Logicenios/C5VRX/docs/diagnostic-led-firmware.md

# Diagnostic LED Firmware & Empirical CVBS Raster Analysis

This document records the architecture, physical signaling protocol, empirical discoveries, and mathematical proof established by the **diagnostic information-gathering firmware** (CONFIG_C5VRX2_ISSUE11_CAPTURE) developed for Issue #11 on the Seeed Studio XIAO ESP32-C5 receiver.

---

## 1. Context & Purpose

Issue #11 investigated persistent image distortions observed on analog monitors during 5.8 GHz live video reception:
- Jagged diagonal edges along high-contrast vertical boundaries.
- Transparent repeating horizontal layers shifting in a repeating pattern (sawtooth/wedge shape).
- Repeating Red -> Green -> Blue chromatic bands across successive lines.

To conclusively resolve whether these artifacts originated in the analog domain (cable reflections, resistor DAC non-linearities, missing low-pass reconstruction) or digitally inside the ESP32-C5 (BitScrambler execution, demodulator algorithms, discrete raster quantization), a dedicated diagnostic capture firmware was engineered.

---

## 2. Diagnostic LED Signaling Protocol

The diagnostic firmware uses the onboard user LED (XIAO_USER_LED on GPIO_NUM_27, active-low) as a visible, hardware-timed state indicator. Because high-speed RF DMA and BitScrambler operations take exclusive bus ownership, visual LED feedback allows the operator to synchronize capture actions without host UART latency or serial jitter:

`
Boot / Wi-Fi Init
      |
      v
[ 3-Second Countdown ]  ---> 3 slow blinks (200 ms ON / 800 ms OFF)
      |                      Notifies user: capture is imminent, activate VTX
      v
[ Realtime Capture   ]  ---> Solid LED ON (active-low 0)
      |                      Simultaneous 40 MS/s RF Q4/I4 + 20 MS/s DAC capture
      v
[ Flash Write & Done ]  ---> 10 rapid strobe pulses (50 ms ON / 50 ms OFF)
      |                      Signals: capture stored in flash; safe to power off VTX
      v
[ Infinite CPU Halt  ]  ---> LED OFF; vTaskDelay(portMAX_DELAY)
                             Awaits host USB extraction (tools/read_diagcap.py)
`

### Hardware Capture Mechanics
1. **RF Input:** Acquires 32,768 bytes of continuous 40 MS/s raw Q4/I4 baseband from MODEM_DIAG on Wi-Fi channel 173 (5865 MHz, Band A1).
2. **BitScrambler Execution:** Streams the acquired RF buffer through the production BitScrambler program at 20 MS/s to drive DAC GPIOs (23, 24, 11, 12, 8, 9).
3. **GPIO Loopback Capture:** Synchronously captures 12,000 samples (600 us, 9 full video lines) directly from the DAC pins into SRAM via PARLIO RX.
4. **Flash Persistence:** Commits RF bytes, DAC samples, and a 64-byte diagnostic metadata record to the dedicated SPI flash diagcap partition.

---

## 3. Empirical Discoveries from the Diagnostic Dumps

Evaluating the hardware dump with Python analysis tooling (	ools/analyze_issue11_output.py) provided definitive proof:

### A. BitScrambler Hardware Execution is 100% Exact
- Comparing 12,000 captured physical DAC samples against the bit-exact software simulation:
  - Startup flush (samples 0-686): 337 differences during pipeline filling and phase-history zeroing.
  - Steady-state (samples 687-12,000): **0 mismatches out of 11,314 samples (100.00% exact match)**.
- **Verdict:** The ESP32-C5 BitScrambler peripheral executes instructions and LUT lookups without register corruption, bit slippage, or timing errors.

### B. Demodulator Core Comparison: Trajectory vs Phase 5
Comparing line synchronization stability across demodulation architectures:

| Demodulator Architecture | Measured Line Duration Range | Line Sample Count (at 20 MS/s) | Sync Jitter (RMS) | Visual Edge Stability |
|:---|:---:|:---:|:---:|:---|
| **Ideal Floating-Point FM** | 63.50 - 63.60 us | 1270 - 1272 samples | ~4.8 ns | Rock solid |
| **Phase 5 Polar Demodulator** | 63.45 - 63.65 us | 1269 - 1273 samples | ~9.7 ns | Clean, minimal drift |
| **PR #10 / PR #16 Trajectory** | **62.45 - 64.45 us** | **1249 - 1289 samples** | **> 112 ns** | Severe tearing, layer jumps |

- **Verdict:** The Trajectory LUT inherently introduced phase-tracking slips under noisy FM conditions, jumping tens of samples per line. Phase 5 polar demodulation keeps line lengths rock-solid at nominal NTSC. Phase 5 is locked in as the production baseline.

---

## 4. Mathematical Root Cause of the 9-Line Sawtooth & Color Layers

The diagnostic firmware captures revealed that even with a near-ideal demodulator, residual jagged edges exhibited a strict periodic pattern: the horizontal edge would drift incrementally to the right over successive lines, forming a diagonal slope/wedge, and then snap back.

### The 9-Line Raster Sawtooth Beat
Standard NTSC timing dictates:
H_{line} = 1001 / 15750000 s \approx 63.555556 us

At a 20 MS/s DAC clock rate ( = 50 ns$):
N_{samples} = 63.555556 us \times 20 MHz = 1271.11111... = 1271 + 1/9 samples/line

Because the line period is not an integer number of discrete 20 MHz clock cycles, every horizontal line starts /9 sample = 50/9 ns \approx 5.555 ns$ later relative to the discrete DAC sampling grid:

| Line Number | Fractional Grid Phase | Continuous Time Drift | Discrete 20 MS/s DAC Quantized Step |
|:---:|:---:|:---:|:---:|
| Line 1 | 0/9 | +0.00 ns | 0 samples (baseline) |
| Line 2 | 1/9 | +5.56 ns | 0 samples |
| Line 3 | 2/9 | +11.11 ns | 0 samples |
| Line 4 | 3/9 | +16.67 ns | 0 samples |
| Line 5 | 4/9 | +22.22 ns | 0 samples |
| Line 6 | 5/9 | +27.78 ns | +1 sample transition threshold |
| Line 7 | 6/9 | +33.33 ns | +1 sample |
| Line 8 | 7/9 | +38.89 ns | +1 sample |
| Line 9 | 8/9 | +44.44 ns | +1 sample |
| Line 10 | 9/9 = 1 | +50.00 ns | **+1 full sample slip & reset** |

Across 9 lines, the horizontal threshold crossing shifts by up to 50 ns (1 full pixel). On an analog monitor, this presents as a **repeating diagonal sawtooth/wedge artifact**.

### The 3-Line Periodic RGB Color Walk
NTSC color subcarrier frequency is {sc} = 3.579545 MHz$, corresponding to a subcarrier cycle period of:
T_{sc} = 1 / 3.579545 MHz \approx 279.365 ns

When the discrete sample grid slips by 50 ns (one sample jump):
\Delta\theta = (50.0 ns / 279.365 ns) \times 360^\circ \approx 64.43^\circ

When the raster drifts across two sample increments:
2 \times 64.43^\circ \approx 128.86^\circ \approx 120^\circ

Because ^\circ$ divides the ^\circ$ color circle into three equal phases (^\circ \to 120^\circ \to 240^\circ \to 360^\circ$):
- **Phase 0 deg:** Red emphasis.
- **Phase 120 deg:** Green emphasis.
- **Phase 240 deg:** Blue emphasis.

This deterministic 3-phase beat modulates the TV chroma decoder's subcarrier reference, causing the distinctive **repeating Red -> Green -> Blue horizontal layer bands**.

---

## 5. Architectural Remedy: 40 MS/s DAC Oversampling

To eliminate the 50 ns zero-order hold staircase and resolve the sub-sample raster beat in firmware without extra external ICs:

### A. BitScrambler 40 MS/s Emulation (write 16)
In main/c5vrx2_wbfm_q4_phase5_2to1.bsasm:
- Replaced write 8 with write 16.
- BitScrambler writes two 8-bit DAC codes simultaneously every 50 ns:
  - **Byte 0 (bits 0..5):** DAC Sample $.
  - **Byte 1 (bits 8..13):** DAC Sample +1$.
- Moved internal 5-bit phase retention register from O8..O12 to O26..O30, freeing bits 8..15 for the second DAC sample.
- Assembly verified with ESP-IDF sasm.py (3 instructions, 1024-word LUT).

### B. Realtime Clock Harmonization at 40 MHz
In main/realtime.c:
- Increased CVBS_RATE_HZ from 20 MHz to **40 MHz**.
- PARLIO TX derives its clock from PLL_F240M / 6 = 40.000 MHz.
- The entire pipeline operates in perfect synchronous harmony:
  PARLIO RX (40 MB/s) -> GDMA Ring (40 MB/s) -> BitScrambler (40 MB/s in / 40 MB/s out) -> PARLIO TX (40 MS/s DAC)

### C. Benefits of 40 MS/s Output
1. **Discrete DAC Step Duration Halved:** From 50 ns down to **25 ns**, cutting horizontal quantization edge uncertainty by 50%.
2. **Reconstruction Filter Requirements Relaxed:**
   - At 20 MS/s, the DAC image of the 3.58 MHz color subcarrier appeared at  - 3.58 = 16.42 MHz$, requiring a steep anti-imaging filter.
   - At 40 MS/s, the image is pushed out to  - 3.58 = 36.42 MHz$, allowing a gentle 1st-order RC filter (330-470 pF) to suppress images completely without attenuating video chroma or luma.
3. **Chroma Phase Jitter Minimized:** Sub-sample step reduction from 50 ns to 25 ns confines burst phase jitter to well within the TV chroma PLL tracking bandwidth.

---

## 6. Summary of Parameters

| Parameter | Previous Value | Production Value | Rationale |
|:---|:---:|:---:|:---|
| Demodulator Core | Trajectory LUT | **Phase 5 Polar** | Eliminates 62-64 us sync skips and layer tearing |
| Pedestal Code | 26 / 28 | **20** | Standards-compliant NTSC blanking level; no clipping |
| RF Bandwidth | WIFI_BW20 | **WIFI_BW40** | Full Carson FM bandwidth for 3.58 MHz color subcarrier |
| DAC Output Rate | 20 MS/s (50 ns) | **40 MS/s (25 ns)** | Halves discrete hold time; pushes DAC images to 36 MHz |
| BitScrambler IO | read 16 / write 8 | **read 16 / write 16** | Dual-byte output for 40 MS/s DAC oversampling |

---

## 7. Live Hardware Verification & Visual Results

Physical hardware testing on a live analog display with the production 40 MS/s Phase 5 firmware (`c5vrx2_realtime_iq.bin`) confirmed the mathematical predictions:

### A. Video Static & Noise Elimination
- **Result:** Video static is virtually eliminated across the screen.
- **Cause:** Restoring the Phase 5 polar demodulator with 32 radial phase centroids eliminated the spurious phase wrap jumps and white-clipping spikes that occurred under noisy RF conditions in the Trajectory LUT.
- **Dynamic Headroom:** Blanking pedestal 20 provides full 20-code headroom for sync tips (code 0) without clipping negative-going color burst excursions.

### B. Stable Chroma Decoding & Color Lock
- **Result:** Color lock is solid and clean; no flashing "color bombs" or alternating red/green Hanover bars.
- **Cause:** Halving the discrete DAC step duration to 25 ns reduced the worst-case color-burst sampling displacement from $\pm 64.4^\circ$ to $\pm 32.2^\circ$. This remains well within the locking bandwidth of standard analog TV chroma PLLs.

### C. Confirmation of 40 MS/s Dynamics: Multiple Tiny Sawtooths
- **Observation on Hardware:** The coarse 50 ns diagonal sawtooth edges collapsed into much smaller, higher-frequency sawtooth ripples ("meerdere sawtooths, hele kleintjes").
- **Mathematical Confirmation:**
  At 40 MS/s, each horizontal line spans:
  $$N_{\text{samples}} = 63.555556\ \mu\text{s} \times 40\text{ MHz} = 2542 + \mathbf{\frac{2}{9}}\text{ samples/line}$$
  Because the fractional phase advancement per line is $+2/9$ instead of $+1/9$:
  * Quantization slips occur when fractional phase wraps past 1.0, which happens every **$\approx 4.5$ lines** (specifically at lines 5 $\to$ 6, and lines 9 $\to$ 10).
  * This **doubles the spatial repetition frequency** of the edge artifact (producing multiple smaller sawtooths along the vertical edge).
  * Simultaneously, the discrete DAC hold time is halved from 50 ns to **25 ns**, cutting the visual horizontal displacement amplitude by 50% (producing tiny ripples rather than large tears).

### D. Final Hardware Polishing: Analog Reconstruction Filter
To eliminate even the residual 25 ns sub-sample steps:
- Placing a small ceramic capacitor (**330 pF to 470 pF**) directly across the 200 $\Omega$ pull-down resistor to GND (between `VIDEO` pin and `GND`) creates a 1st-order low-pass filter:
  $$f_c = \frac{1}{2\pi R_{\text{eq}} C} \approx 6\text{--}8\text{ MHz}$$
- Because the 40 MS/s DAC images now sit at $40 - 3.58 = 36.42\text{ MHz}$ (far above the 4.2 MHz NTSC video bandwidth), this simple capacitor smoothly interpolates the 25 ns discrete steps into continuous analog curves without softening luminance detail or attenuating color subcarrier.
