Logicenios/C5VRX/measurements/pr16-linear80/synthetic-spectrum.png

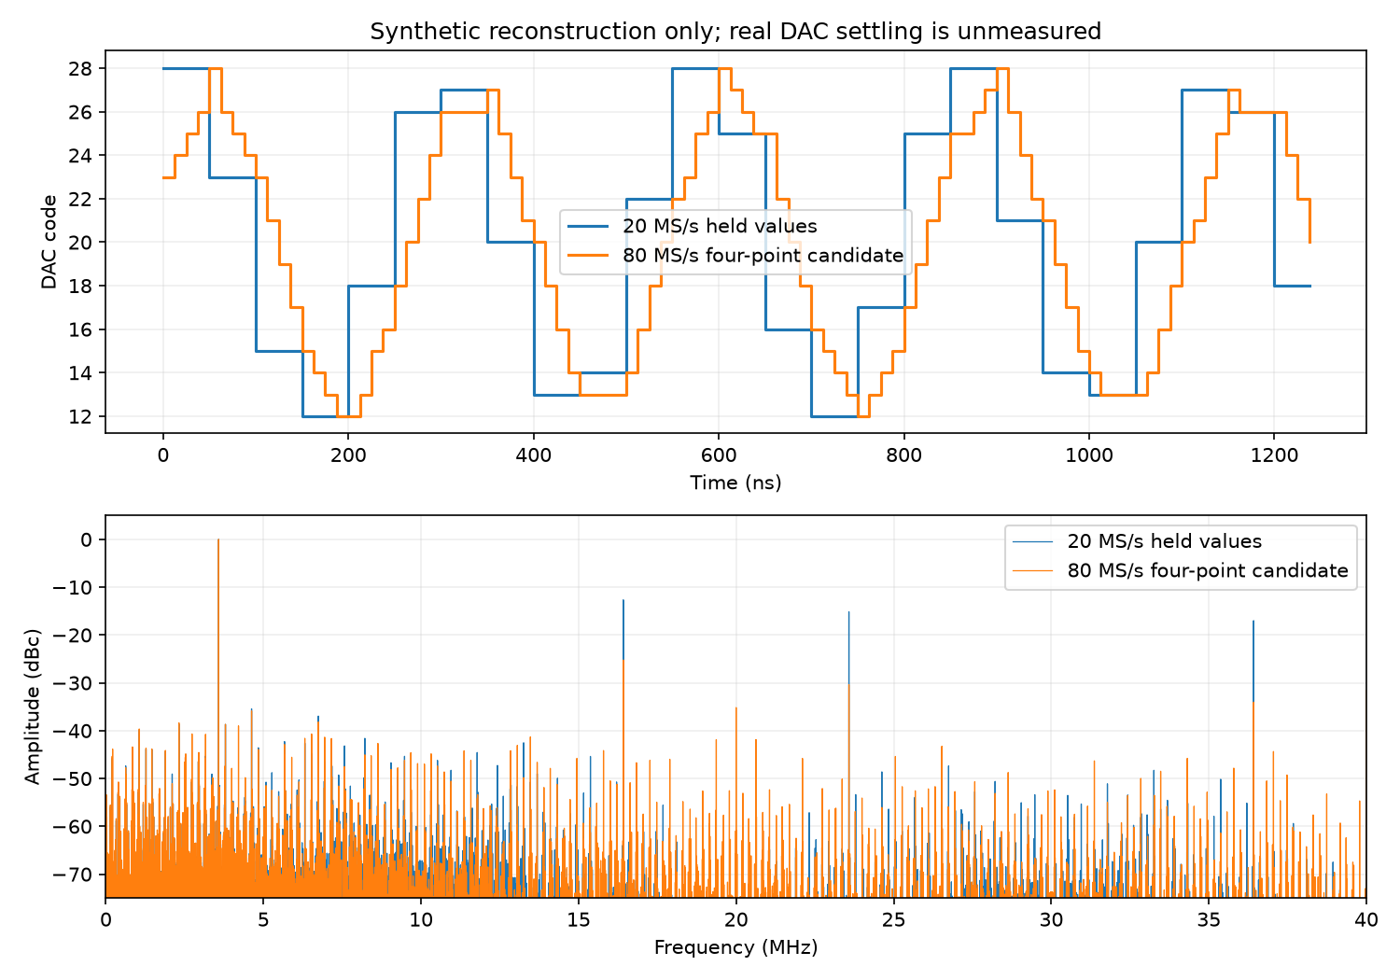
measurements/pr16-linear80/synthetic-spectrum.png
