Logicenios/C5VRX/measurements/issue-11-cvbs/diagcap_dump.csv

edge_sample | edge_us | hsync_fit_residual_ns | line_length_samples | line_length_us | ntsc_burst_global_phase_deg | ntsc_burst_peak_codes | ntsc_burst_phase_at_hsync_deg | ntsc_burst_residual_rms_codes | pal_burst_global_phase_deg | pal_burst_peak_codes | pal_burst_phase_at_hsync_deg | pal_burst_residual_rms_codes | sync_width_us
1019.3076923076923 | 50.965384615384615 | 48.06959706954217 |  |  | 55.589991498526416 | 5.052669986814524 | -148.56210641190185 | 7.58932372256705 | -134.90313013594644 | 3.286632546438985 | -148.9125907128689 | 8.052151830128151 | 5.05
2289.55 | 114.4775 | -14.632326007358643 | 1270.2423076923078 | 63.51211538461539 | 8.901920894284721 | 3.6812721874035823 | -71.22876094261218 | 7.879611118388635 | 26.344889488468127 | 3.190042372113531 | -135.8025473864992 | 7.990495283366636 | 5.25
3562.5714285714284 | 178.12857142857143 | 61.62179487173489 | 1273.0214285714283 | 63.651071428571406 | 10.485254972370392 | 6.241455133039812 | -126.56019960222181 | 6.003829268983725 | -78.72883716632185 | 1.2593877889061385 | -167.22612645199573 | 7.386235806275949 | 5.1000000000000005
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
