Logicenios/C5VRX/measurements/issue-11-cvbs/diagcap_dump.png

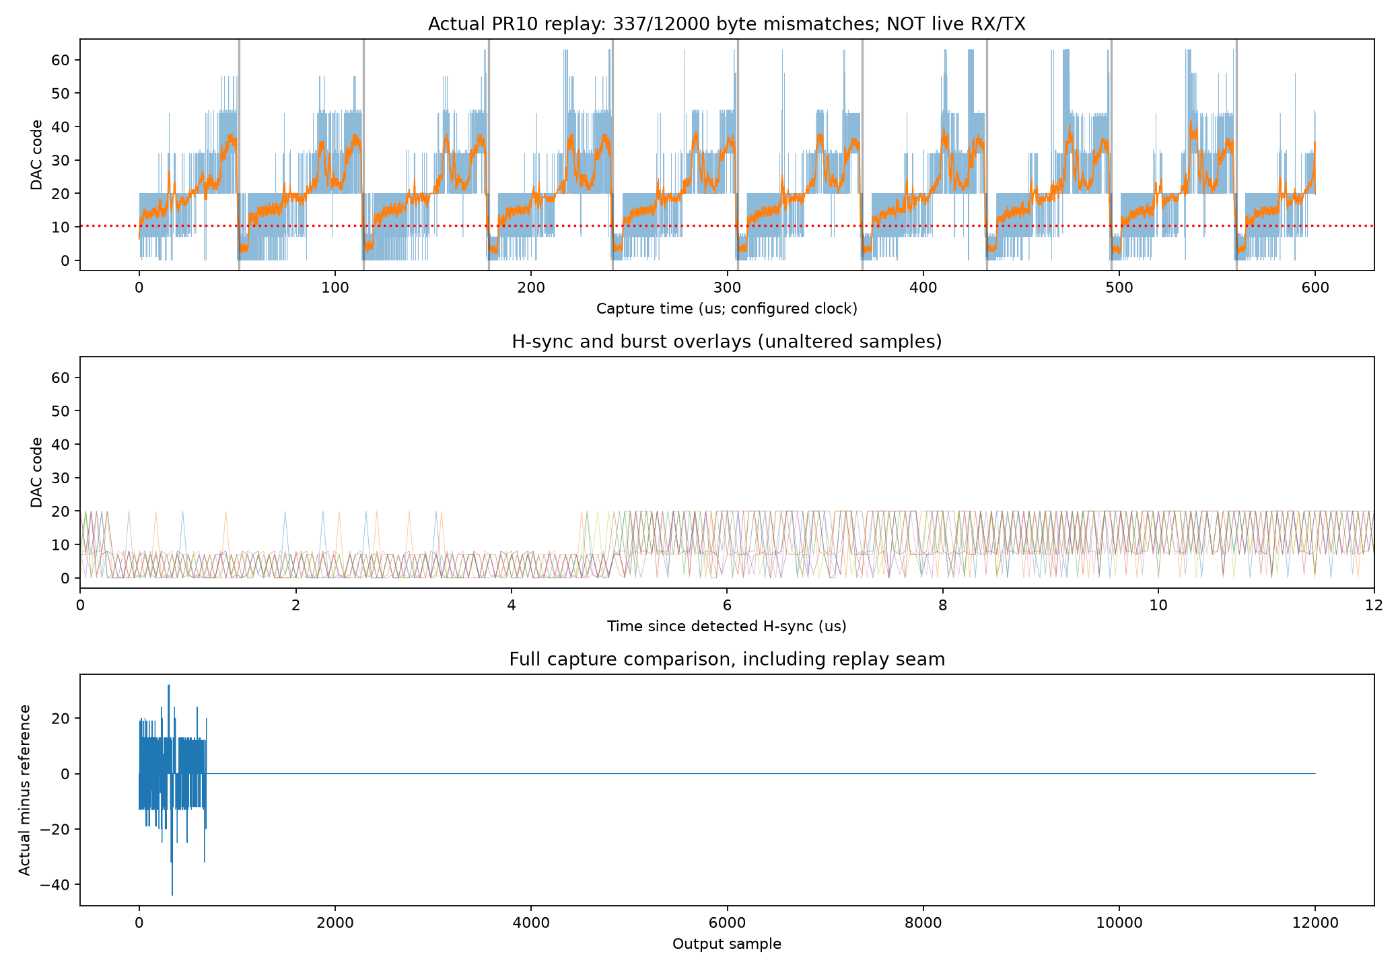
measurements/issue-11-cvbs/diagcap_dump.png
