Logicenios/C5VRX/main/video.c

/**
 * video.c - Realtime MODEM_DIAG -> PARLIO RX -> 32K ring -> Phase5 TX -> DAC.
 *
 * Implements the complete production datapath for C5VRX-3:
 *
 *   MODEM_DIAG full Q4/I4 @ 40 MS/s
 *     -> PARLIO RX POS edge @ 40 MHz
 *     -> 32 KiB cyclic raw DMA ring (HP SRAM)
 *     -> PARLIO TX + selectable Golden Phase5 / Trajectory v2 BitScrambler
 *     -> [D,D] 6-bit CVBS @ 20 MS/s unique / 40 MHz DAC clock
 *     -> 6-bit resistor DAC
 *
 * Reference: Seamless Golden 16K (build-golden-notel) -- proven best live build.
 *
 * Fixed production constants (NOT configurable at runtime):
 *   IQ rate:        40 MHz
 *   DAC rate:       40 MHz physical ([D,D] = 20 MS/s unique CVBS)
 *   Ring:           32768 bytes (HP SRAM, DMA-aligned)
 *   Pedestal:       20   (hardcoded in FM LUT)
 *   Gain:           2    (hardcoded in FM LUT)
 *   Polarity:       current-minus-previous (hardcoded in FM LUT)
 *   RX sample edge: POS
 *   TX shift edge:  NEG
 *   BS EOF:         downstream (PARLIO TX loop never generates downstream EOF)
 *   BS tail:        0 bytes
 *
 * DMA owns sample pacing; tasks handle AGC, buttons and console commands.
 */

#include "video.h"
#include "rf.h"
#include "menu_font.h"
#include "menu_raster.h"
#include "range_control.h"
#include "demod_quality.h"
#include "fusion_receiver.h"
#include "fusion_temporal.h"
#include "fusion_optimizer.h"
#include "arc_controller.h"
#include "arc_v3_controller.h"
#include "arc_v5_autotune.h"
#include "rx_auto_lab.h"
#include "trajectory_v2_lut.h"
#include "hal/parlio_ll.h"
#include "hal/usb_serial_jtag_ll.h"

#include <stdint.h>
#include <inttypes.h>
#include <string.h>
#include <fcntl.h>
#include <unistd.h>

#include "driver/usb_serial_jtag_vfs.h"
#include "driver/bitscrambler.h"
#include "driver/gpio.h"
#include "driver/parlio_rx.h"
#include "driver/parlio_tx.h"
#include "esp_attr.h"
#include "esp_cache.h"
#include "esp_log.h"
#include "esp_heap_caps.h"
#include "esp_system.h"
#include "nvs.h"
#include "esp_rom_sys.h"
#include "esp_timer.h"
#include "freertos/FreeRTOS.h"
#include "freertos/queue.h"
#include "freertos/task.h"
#include "soc/parl_io_struct.h"
#include "soc/bitscrambler_struct.h"
#include "soc/ahb_dma_struct.h"
#include "soc/pcr_struct.h"
#include "modem/modem_syscon_reg.h"
#include "hal/dma_types.h"
#include "esp_clock_output.h"

/* Hardware diagnostic counters in IRAM to measure transport hiccups without printf spam */
typedef struct {
    uint32_t parl_rx_wovf_count;
    uint32_t parl_tx_rempty_count;
    uint32_t parl_tx_eof_count;
    uint32_t gdma_in_fault_count;
    uint32_t gdma_out_fault_count;
    uint32_t bs_fifo_empty_count;
    uint32_t bs_eof_overload_count;
    uint32_t lag_event_count;
    uint32_t near_gain_event_count;
    uint32_t near_phy_event_count;
    uint32_t gain_quality_drop_count;
    uint32_t user_lag_mark_count;
    uint32_t checks;
} hw_transport_counters_t;

enum {
    LAG_EVT_PARLIO_TX_REMPTY = 1u << 0,
    LAG_EVT_PARLIO_RX_WOVF   = 1u << 1,
    LAG_EVT_PARLIO_TX_EOF    = 1u << 2,
    LAG_EVT_GDMA_IN_FAULT    = 1u << 3,
    LAG_EVT_GDMA_OUT_FAULT   = 1u << 4,
    LAG_EVT_BS_EOF_OVERLOAD  = 1u << 5,
};

enum {
    PHY_WRITE_NONE   = 0,
    PHY_WRITE_GAIN   = 1,
    PHY_WRITE_BW     = 2,
    PHY_WRITE_OFFSET = 3,
    PHY_WRITE_FFT    = 4,
};

#define LAG_EVENT_LOG_SIZE 12u
#define GDMA_IN_FAULT_MASK  0xfcu /* ERR_EOF, DSCR_ERR/EMPTY, FIFO OVF/UDF, AHB response */
#define GDMA_OUT_FAULT_MASK 0x7cu /* DSCR_ERR, TOTAL_EOF, FIFO OVF/UDF, AHB response */

typedef struct {
    int64_t time_us;
    uint32_t seq;
    uint32_t flags;
    uint16_t rx_off;
    uint16_t tx_off;
    uint8_t gain;
    uint8_t agc_state;
} lag_event_t;

static volatile hw_transport_counters_t s_hw_counters;
static lag_event_t s_lag_events[LAG_EVENT_LOG_SIZE];
static volatile uint32_t s_lag_event_head;
static volatile int64_t s_last_gain_write_us;
static volatile int64_t s_last_phy_write_us;
static volatile uint8_t s_last_phy_write_kind;
static volatile int64_t s_last_transport_event_us;
static volatile uint32_t s_last_transport_flags;
static volatile uint32_t s_last_gain_drop_transition;
static volatile int64_t s_last_user_lag_mark_us;

/* fm.bsasm program symbol generated by target_bitscrambler_add_src(). */
BITSCRAMBLER_PROGRAM(s_fm_program, "fm");
BITSCRAMBLER_PROGRAM(s_fm4_program, "fm4");
BITSCRAMBLER_PROGRAM(s_fm_traj_program, "fm_traj");

/* ----- Fixed production constants ----- */
#define IQ_RATE_HZ       40000000u   /* MODEM_DIAG / PARLIO RX clock */
#define DAC_RATE_HZ      40000000u   /* default 6-bit PARLIO TX clock */
#define DAC4_RATE_HZ     80000000u   /* experimental 4-bit PARLIO TX clock */
#define RAW_RING_BYTES   32768u      /* 32 KiB cyclic ring; Golden Phase5 datapath */
#define DAC_IDLE_CODE    20u         /* Black/blanking pedestal; sync is 0 */
#define BOOT_BTN_GPIO    GPIO_NUM_28 /* Seeed Studio XIAO ESP32-C5 BOOT Button */
#define MENU_RUNTIME_ENABLED 1       /* Native CVBS menu enabled after geometry rework */
#define CONTROL_SAMPLE_BYTES 4092u  /* one complete, already-finished GDMA descriptor */
#define FUSION_FAST_SAMPLE_BYTES 512u /* distributed shadow window; never paces live IQ */
#define FUSION_FAST_PERIOD_MS 6u      /* ~8 observations per 50 ms actuator period */
#define GAIN_SETTLE_TICKS 10        /* 500 ms decision hold after a physical gain write */
#define GAIN_SEARCH_PROBE_TICKS 20  /* 1.0 s between no-carrier sensitivity probes */
#define PERIODIC_TELEMETRY 0        /* keep live control path silent; diagnostics are on-demand */
#define LAB_GAIN_MIN       2u        /* production controller lower bound */
#define LAB_GAIN_MAX       62u       /* production controller upper bound */
#define LAB_GAIN_STEP      2u        /* characterize the states production actually uses */
#define LAB_GAIN_SETTLE_MS 700u      /* measure after the existing 500 ms gain hold */
#define LAB_GAIN_DWELL_MS  1000u     /* one second per state for scope/video correlation */
#define LAB_FFT_SETTLE_MS  550u      /* FFT probe: wait beyond one control/settle interval */
#define LAB_FFT_DWELL_MS   750u      /* short bounded dwell; lab-only, never production */
#define LAB_BW_SETTLE_MS   800u      /* allow analog filter change before measurement */
#define LAB_PREQ4_SETTLE_MS 850u      /* raw-Q4 settle after TX/noise-state change */
#define RX_AUTO_SAMPLE_COUNT       5u
#define RX_AUTO_SAMPLE_SPACING_MS 60u
#define RX_AUTO_GAIN_SETTLE_MS    600u
#define RX_AUTO_BW_SETTLE_MS      800u
#define RX_AUTO_OFFSET_SETTLE_MS  650u
#define RX_AUTO_TOP_COUNT         3u
#define RX_AUTO_PROOF_ROUNDS      5u

typedef enum {
    VIDEO_STD_MODE_AUTO = 0,
    VIDEO_STD_MODE_NTSC = 1,
    VIDEO_STD_MODE_PAL  = 2,
} video_standard_mode_t;

static volatile video_standard_mode_t s_video_std_mode = VIDEO_STD_MODE_AUTO;
static volatile video_standard_t s_video_std = VIDEO_STD_NTSC;
static volatile video_standard_t s_detected_video_std = VIDEO_STD_NTSC;
static volatile bool s_detected_video_std_valid;
static volatile uint8_t s_video_std_pal_score;
static volatile uint8_t s_video_std_ntsc_score;
static volatile uint16_t s_last_line_period_20m;
static volatile uint16_t s_last_sync_width_20m;
static volatile int s_last_sync_quality;
static QueueHandle_t s_menu_commands;
static bitscrambler_handle_t s_flight_bs;

/* Cache synchronization helpers for DMA buffers and descriptors on ESP32-C5.
 * Aligns address down and size up to 64-byte cache line boundaries so esp_cache_msync
 * never fails with ESP_ERR_INVALID_ARG on unaligned descriptors or buffers. */
static inline void sync_dma_c2m(const void *addr, size_t size)
{
    if (!addr || size == 0) return;
    uint32_t start = (uint32_t)addr & ~(64u - 1u);
    uint32_t end = ((uint32_t)addr + size + 63u) & ~(64u - 1u);
    (void)esp_cache_msync((void *)start, end - start,
                          ESP_CACHE_MSYNC_FLAG_DIR_C2M | ESP_CACHE_MSYNC_FLAG_UNALIGNED);
}

static inline void sync_dma_m2c(const void *addr, size_t size)
{
    if (!addr || size == 0) return;
    uint32_t start = (uint32_t)addr & ~(64u - 1u);
    uint32_t end = ((uint32_t)addr + size + 63u) & ~(64u - 1u);
    (void)esp_cache_msync((void *)start, end - start,
                          ESP_CACHE_MSYNC_FLAG_DIR_M2C | ESP_CACHE_MSYNC_FLAG_UNALIGNED);
}

/* Timing and descriptors are immutable while running; only text pixels change.
 * This raster is never linked to the RF ring. */
static DMA_ATTR __attribute__((aligned(64))) menu_raster_t s_menu_raster;
/* The two-field PAL/NTSC scatter chain is below 20 KiB. Descriptors are needed
 * only while the standalone menu owns TX, so allocate the bounded maximum from
 * internal AHB-DMA descriptor memory and return it on exit. */
static dma_descriptor_t *s_menu_nodes;
static unsigned s_menu_node_capacity;
/* AGC sampling and channel scan are serialized in analog_agc_task, so they
 * share one descriptor-sized CPU snapshot instead of reserving 8 KiB. */
static uint8_t s_control_sample_buf[CONTROL_SAMPLE_BYTES];
static unsigned s_menu_node_count;
static volatile bool s_menu_active;
static volatile bool s_menu_boot_btn_enabled = true;
static volatile int s_menu_cursor;
static int s_menu_timeout_ticks;

typedef enum {
    RF_BW_MODE_BW40 = 0,
    RF_BW_MODE_BW20 = 1,
    RF_BW_MODE_AUTO = 2,
} rf_bw_mode_t;

typedef enum {
    VIDEO_OUTPUT_6BIT_40 = 0,
    VIDEO_OUTPUT_4BIT_80 = 1,
} video_output_mode_t;

typedef enum {
    DEMOD_MODE_GOLDEN_PHASE5 = 0,
    DEMOD_MODE_TRAJECTORY_V2 = 1,
    DEMOD_MODE_COUNT,
} demod_mode_t;

typedef enum {
    RX_PROFILE_BALANCED = 0,
    RX_PROFILE_RANGE_EXP,
    RX_PROFILE_BLOCKER_EXP,
    RX_PROFILE_RECOVERY_EXP,
    RX_PROFILE_AUTO_EXP,
    RX_PROFILE_ARC,
    RX_PROFILE_FUSION_EXP,
    RX_PROFILE_RANGE_V2_EXP,
    RX_PROFILE_ARC_V3_EXP,
    RX_PROFILE_ARC_V5_AUTOTUNE_EXP,
    RX_PROFILE_COUNT,
} rx_profile_t;

static volatile rf_bw_mode_t s_rf_bw_mode = RF_BW_MODE_BW40;
static volatile bool s_current_bw40 = true;
static volatile video_output_mode_t s_output_mode = VIDEO_OUTPUT_6BIT_40;
static video_output_mode_t s_tx_unit_mode = VIDEO_OUTPUT_6BIT_40;
static volatile demod_mode_t s_demod_mode = DEMOD_MODE_GOLDEN_PHASE5;
static volatile rx_profile_t s_rx_profile = RX_PROFILE_ARC;
static volatile arc_v3_state_t s_last_arc_v3_state = ARC_V3_ACQUIRE;
static volatile arc_v3_q4_state_t s_last_arc_v3_q4_state = ARC_V3_Q4_STARVED;
static volatile bool s_last_arc_v3_filtered_valid;
static volatile int s_last_arc_v3_filtered_p;
static volatile int s_last_arc_v3_filtered_q;
static volatile int s_last_arc_v3_filtered_clip;
static volatile int s_last_arc_v3_filtered_origin;
static volatile unsigned s_last_arc_v3_up_guard;
static volatile uint32_t s_profile_generation;
static volatile bool s_profile_fft_forced;
static volatile bool s_fft_q4_effect_known;
static volatile bool s_fft_q4_effective;
static volatile int8_t s_fft_best_value;
static volatile int s_last_noise_floor_dbm = -127;
static volatile int s_last_phy_rssi_dbm = -127;
static volatile bool s_noise_floor_valid;
static volatile bool s_phy_rssi_valid;

/* TX GPIO mapping: 6-bit resistor DAC.
 * Order: DAC bit 0 (LSB) .. DAC bit 5 (MSB) on data_gpio_nums[0..5].
 * Bits 6..7 unused (set to -1).
 * Verified against C5VRX-2 realtime.c (standard 8-bit PARLIO TX, non-parlio4). */
static const int s_dac_gpio[8] = {23, 24, 11, 12, 8, 9, -1, -1};
/* 4-bit mode drives the four MSB resistor branches: weights 4/8/16/32. */
static const int s_dac4_gpio[4] = {11, 12, 8, 9};

_Static_assert(IQ_RATE_HZ == 40000000u, "IQ rate must be 40 MHz");
_Static_assert(DAC_RATE_HZ == 40000000u, "DAC rate must be 40 MHz");
_Static_assert(RAW_RING_BYTES == 32768u, "Ring must be exactly 32768 bytes");
_Static_assert(CONTROL_SAMPLE_BYTES <= 4092u, "Control window must fit one GDMA descriptor");
_Static_assert(FUSION_FAST_SAMPLE_BYTES <= 4092u, "Fusion shadow window must fit one GDMA descriptor");

static const char *TAG = "c5vrx3_video";

/* DMA-aligned ring buffer in HP SRAM.
 * RX GDMA writes at 40 MB/s; TX GDMA reads at 40 MB/s.
 * TX starts one block (4096 bytes = 102.4 µs) behind RX; they share
 * PLL_F240M/6, so separation cannot drift during normal operation. */
static DMA_ATTR __attribute__((aligned(64))) uint8_t s_raw_ring[RAW_RING_BYTES];

static parlio_rx_unit_handle_t      s_rx;
static parlio_rx_delimiter_handle_t s_rx_delimiter;
static parlio_tx_unit_handle_t      s_tx;

/* ----- PARLIO RX setup ----- */

static esp_err_t prepare_rx(void)
{
    /* Proven PARLIO RX config with clean internal SPLL clock */
    const parlio_rx_unit_config_t cfg = {
        .trans_queue_depth = 1u,
        .max_recv_size     = sizeof(s_raw_ring),
        .dma_burst_size    = 32u,
        .data_width        = 8u,
        .clk_src           = PARLIO_CLK_SRC_DEFAULT,
        .ext_clk_freq_hz   = 0u,
        .exp_clk_freq_hz   = IQ_RATE_HZ,
        .clk_in_gpio_num   = -1,
        .clk_out_gpio_num  = -1,
        .valid_gpio_num    = -1,
        /* GPIO order must match s_iq_pins[] in rf.c:
         * Q[9:6] on GPIO 1,0,25,7 then I[9:6] on GPIO 10,5,3,4. */
        .data_gpio_nums    = {
            GPIO_NUM_1, GPIO_NUM_0, GPIO_NUM_25, GPIO_NUM_7,
            GPIO_NUM_10, GPIO_NUM_5, GPIO_NUM_3, GPIO_NUM_4,
        },
        .flags = {
            .free_clk    = true,   /* RX clock is derived from PHY, not gated */
            .clk_gate_en = false,
            .allow_pd    = false,
        },
    };
    esp_err_t err = parlio_new_rx_unit(&cfg, &s_rx);
    if (err != ESP_OK) return err;

    /* Soft delimiter in infinite (partial_rx_en) mode.
     * POS sample edge -- proven correct for internal clock. */
    const parlio_rx_soft_delimiter_config_t delim_cfg = {
        .sample_edge  = PARLIO_SAMPLE_EDGE_POS,
        .bit_pack_order = PARLIO_BIT_PACK_ORDER_LSB,
        .eof_data_len = sizeof(s_raw_ring),
        .timeout_ticks = 0u,
    };
    err = parlio_new_rx_soft_delimiter(&delim_cfg, &s_rx_delimiter);
    if (err != ESP_OK) return err;

    return parlio_rx_unit_enable(s_rx, false);
}

/* ----- PARLIO TX setup ----- */

static esp_err_t create_tx_unit(video_output_mode_t mode)
{
    const bool four_bit = mode == VIDEO_OUTPUT_4BIT_80;
    parlio_tx_unit_config_t cfg = {
        .clk_src               = PARLIO_CLK_SRC_DEFAULT,
        .clk_in_gpio_num       = -1,
        .input_clk_src_freq_hz = 0u,
        .output_clk_freq_hz    = four_bit ? DAC4_RATE_HZ : DAC_RATE_HZ,
        .data_width            = four_bit ? 4u : 8u,
        .data_gpio_nums        = {-1, -1, -1, -1, -1, -1, -1, -1},
        .clk_out_gpio_num      = -1,
        .valid_gpio_num        = -1,
        .valid_start_delay     = 0,
        .valid_stop_delay      = 0,
        .trans_queue_depth     = 1u,
        .max_transfer_size     = sizeof(s_raw_ring),
        .dma_burst_size        = 32u,
        .shift_edge            = PARLIO_SHIFT_EDGE_NEG,
        .bit_pack_order        = PARLIO_BIT_PACK_ORDER_LSB,
    };

    if (four_bit) {
        for (unsigned i = 0; i < 4u; ++i) cfg.data_gpio_nums[i] = s_dac4_gpio[i];
    } else {
        for (unsigned i = 0; i < 8u; ++i) cfg.data_gpio_nums[i] = s_dac_gpio[i];
    }

    esp_err_t err = parlio_new_tx_unit(&cfg, &s_tx);
    if (err != ESP_OK) return err;

    /* Keep the two unused LSB resistor branches low in 4-bit mode so the
     * existing six-resistor DAC can be used without rewiring. */
    if (four_bit) {
        gpio_set_direction((gpio_num_t)s_dac_gpio[0], GPIO_MODE_OUTPUT);
        gpio_set_direction((gpio_num_t)s_dac_gpio[1], GPIO_MODE_OUTPUT);
        gpio_set_level((gpio_num_t)s_dac_gpio[0], 0);
        gpio_set_level((gpio_num_t)s_dac_gpio[1], 0);
    }

    s_tx_unit_mode = mode;
    return ESP_OK;
}

static esp_err_t replace_tx_unit(video_output_mode_t mode)
{
    esp_err_t err = parlio_del_tx_unit(s_tx);
    if (err != ESP_OK) return err;
    s_tx = NULL;
    return create_tx_unit(mode);
}

static esp_err_t prepare_tx(void)
{
    esp_err_t err = create_tx_unit(s_output_mode);
    if (err != ESP_OK) return err;

    const bitscrambler_config_t bs_cfg = {
        .dir = BITSCRAMBLER_DIR_TX,
        .attach_to = SOC_BITSCRAMBLER_ATTACH_PARL_IO,
    };
    err = bitscrambler_new(&bs_cfg, &s_flight_bs);
    if (err != ESP_OK) return err;

    return parlio_tx_unit_enable(s_tx);
}

/* ----- Start RX cyclic ring ----- */

static esp_err_t start_rx(void)
{
    esp_err_t err = parlio_rx_soft_delimiter_start_stop(s_rx, s_rx_delimiter, true);
    if (err != ESP_OK) return err;
    const parlio_receive_config_t cfg = {
        .delimiter = s_rx_delimiter,
        .flags = {
            .partial_rx_en   = true,
            .indirect_mount  = false,
        },
    };
    return parlio_rx_unit_receive(s_rx, s_raw_ring, sizeof(s_raw_ring), &cfg);
}

/* ----- Start TX loop ----- */

static esp_err_t start_tx(void)
{
    /* Phase5 LUT is embedded in fm.bsasm -- no runtime bitscrambler_load_lut().
     * Hardware oracle v9 proved embedded LUT is byte-exact at 20 MS/s;
     * a separately preloaded LUT is NOT retained by the active PARLIO TX run. */
    const parlio_transmit_config_t cfg = {
        .idle_value          = s_output_mode == VIDEO_OUTPUT_4BIT_80 ? (DAC_IDLE_CODE >> 2) : DAC_IDLE_CODE,
        .bitscrambler_program = NULL, /* s_flight_bs is controlled explicitly */
        .flags.loop_transmission = true,  /* Infinite -- never generates downstream EOF */
    };
    /* TX reads sizeof(s_raw_ring) * 8 bits, then loops.
     * loop_transmission=true means PARLIO TX never stops; the BitScrambler
     * with eof_on=downstream therefore runs uninterrupted forever. */
    return parlio_tx_unit_transmit(s_tx, s_raw_ring,
                                   sizeof(s_raw_ring) * 8u, &cfg);
}

static int s_rx_dma_ch = -1;
static int s_tx_dma_ch = -1;

static inline uint32_t get_rx_dma_offset(uint32_t *out_dscr_addr)
{
    if (s_rx_dma_ch < 0 || s_rx_dma_ch >= 3) return 0;
    uint32_t dscr_addr = AHB_DMA.channel[s_rx_dma_ch].in.in_dscr_bf0.val;
    if (out_dscr_addr) *out_dscr_addr = dscr_addr;
    if (dscr_addr >= 0x40800000u && dscr_addr < 0x40860000u) {
        dma_descriptor_t *dscr = (dma_descriptor_t *)(uintptr_t)dscr_addr;
        uint8_t *buf = (uint8_t *)dscr->buffer;
        if (buf >= s_raw_ring && buf < s_raw_ring + sizeof(s_raw_ring)) {
            return (uint32_t)(buf - s_raw_ring);
        }
    }
    return 0;
}

static inline uint32_t get_tx_dma_offset(uint32_t *out_dscr_addr)
{
    if (s_tx_dma_ch < 0 || s_tx_dma_ch >= 3) return 0;
    uint32_t dscr_addr = AHB_DMA.channel[s_tx_dma_ch].out.out_dscr_bf0.val;
    if (out_dscr_addr) *out_dscr_addr = dscr_addr;
    if (dscr_addr >= 0x40800000u && dscr_addr < 0x40860000u) {
        dma_descriptor_t *dscr = (dma_descriptor_t *)(uintptr_t)dscr_addr;
        uint8_t *buf = (uint8_t *)dscr->buffer;
        if (buf >= s_raw_ring && buf < s_raw_ring + sizeof(s_raw_ring)) {
            return (uint32_t)(buf - s_raw_ring);
        }
    }
    return 0;
}

#define MAX_RING_DESCRIPTORS 16

typedef struct {
    dma_descriptor_t *dscr;
    uint8_t *buffer;
    uint32_t length;
} ring_dscr_node_t;

static ring_dscr_node_t s_rx_dscr_nodes[MAX_RING_DESCRIPTORS];
static int s_rx_dscr_count = 0;

static ring_dscr_node_t s_tx_dscr_nodes[MAX_RING_DESCRIPTORS];
static int s_tx_dscr_count = 0;

static inline int find_dscr_index(const ring_dscr_node_t *nodes, int count, uint32_t addr)
{
    for (int i = 0; i < count; i++) {
        if ((uintptr_t)nodes[i].dscr == addr) return i;
    }
    return -1;
}

static int patch_descriptors_clear_eof(int dma_ch, bool is_rx)
{
    if (dma_ch < 0 || dma_ch >= 3) return 0;
    uint32_t first_addr = is_rx ? AHB_DMA.channel[dma_ch].in.in_dscr_bf0.val
                                : AHB_DMA.channel[dma_ch].out.out_dscr_bf0.val;
    if (first_addr < 0x40800000u || first_addr >= 0x40860000u) return 0;

    dma_descriptor_t *curr = (dma_descriptor_t *)(uintptr_t)first_addr;
    int count = 0;
    if (is_rx) s_rx_dscr_count = 0;
    else s_tx_dscr_count = 0;

    while (curr && count < MAX_RING_DESCRIPTORS) {
        curr->dw0.suc_eof = 0;
        sync_dma_c2m(curr, sizeof(dma_descriptor_t));

        if (is_rx) {
            s_rx_dscr_nodes[count].dscr = curr;
            s_rx_dscr_nodes[count].buffer = (uint8_t *)curr->buffer;
            s_rx_dscr_nodes[count].length = curr->dw0.size ? curr->dw0.size : 4092u;
        } else {
            s_tx_dscr_nodes[count].dscr = curr;
            s_tx_dscr_nodes[count].buffer = (uint8_t *)curr->buffer;
            s_tx_dscr_nodes[count].length = curr->dw0.size ? curr->dw0.size : 4092u;
        }

        curr = curr->next;
        count++;
        if ((uintptr_t)curr == first_addr) break;
    }
    if (is_rx) s_rx_dscr_count = count;
    else s_tx_dscr_count = count;

    __asm__ __volatile__("fence rw, rw" ::: "memory");
    return count;
}

/* Pick a descriptor that RX has already completed, rather than sampling a
 * fixed address that GDMA may be overwriting at the same instant. The control
 * loop now consumes one complete 4092-byte descriptor per 50 ms evaluation. */
static uint8_t *get_completed_rx_sample_window(size_t bytes)
{
    if (s_rx_dma_ch < 0 || s_rx_dma_ch >= 3 || s_rx_dscr_count < 2) {
        return s_raw_ring;
    }

    uint32_t current_addr = AHB_DMA.channel[s_rx_dma_ch].in.in_dscr_bf0.val;
    int current_idx = find_dscr_index(s_rx_dscr_nodes, s_rx_dscr_count, current_addr);
    if (current_idx < 0) {
        return s_raw_ring;
    }

    for (int back = 1; back < s_rx_dscr_count; ++back) {
        int idx = (current_idx - back + s_rx_dscr_count) % s_rx_dscr_count;
        uint8_t *buf = s_rx_dscr_nodes[idx].buffer;
        uint32_t len = s_rx_dscr_nodes[idx].length;
        if (buf && len >= bytes &&
            buf >= s_raw_ring && (buf + bytes) <= (s_raw_ring + sizeof(s_raw_ring))) {
            return buf;
        }
    }
    return s_raw_ring;
}


/* Exact Phase5 state decode mirrored from the embedded fm.bsasm LUT.  The
 * detector is observation-only: the realtime BitScrambler remains the sole
 * live demodulator. */
static const uint8_t s_phase5_state_lut[256] = {
     4,  6,  7,  7,  7,  8,  8,  8, 24, 24, 24, 25, 25, 25, 26, 28,
     2,  4,  5,  6,  6,  7,  7,  7, 25, 25, 25, 26, 26, 27, 28, 30,
     1,  3,  4,  5,  5,  6,  6,  6, 26, 26, 26, 27, 27, 28, 29, 31,
     1,  2,  3,  4,  5,  5,  5,  6, 26, 27, 27, 27, 28, 29, 30, 31,
     1,  2,  3,  3,  4,  5,  5,  5, 27, 27, 27, 28, 29, 29, 30, 31,
     0,  1,  2,  3,  3,  4,  4,  5, 27, 28, 28, 28, 29, 30, 31,  0,
     0,  1,  2,  3,  3,  4,  4,  4, 28, 28, 28, 29, 29, 30, 31,  0,
     0,  1,  2,  2,  3,  3,  4,  4, 28, 28, 29, 29, 30, 30, 31,  0,
    16, 15, 14, 14, 13, 13, 12, 12, 20, 20, 19, 19, 18, 18, 17, 16,
    16, 15, 14, 13, 13, 12, 12, 12, 20, 20, 20, 19, 19, 18, 17, 16,
    16, 15, 14, 13, 13, 12, 12, 11, 21, 20, 20, 19, 19, 18, 17, 16,
    15, 14, 13, 13, 12, 12, 11, 11, 21, 21, 21, 20, 19, 19, 18, 17,
    15, 14, 13, 12, 11, 11, 11, 10, 22, 21, 21, 21, 20, 19, 18, 17,
    15, 13, 12, 11, 11, 10, 10, 10, 22, 22, 22, 21, 21, 20, 19, 17,
    14, 12, 11, 10, 10,  9,  9,  9, 23, 23, 23, 22, 22, 21, 20, 18,
    12, 10,  9,  9,  9,  8,  8,  8, 24, 24, 24, 23, 23, 23, 22, 20,
};

/* Bit i is 1 when the production fm.bsasm delta LUT maps that
 * (previous_phase5,current_phase5) pair to DAC code <= 8.  This compact mask
 * lets the control task recognize real H-sync tips without duplicating the
 * 1024-entry output LUT or using floating point. */
static const uint8_t s_phase5_sync_mask[128] = {
    0x00, 0x00, 0x80, 0x3f, 0x00, 0x00, 0x00, 0xff, 0x00, 0x00, 0x00, 0xfe, 0x03, 0x00, 0x00, 0xfc,
    0x07, 0x00, 0x00, 0xf8, 0x0f, 0x00, 0x00, 0xf0, 0x1f, 0x00, 0x00, 0xe0, 0x3f, 0x00, 0x00, 0xc0,
    0x3f, 0x00, 0x00, 0x80, 0xff, 0x00, 0x00, 0x00, 0xfe, 0x00, 0x00, 0x00, 0xfc, 0x01, 0x00, 0x00,
    0xf8, 0x07, 0x00, 0x00, 0xf0, 0x0f, 0x00, 0x00, 0xe0, 0x1f, 0x00, 0x00, 0xc0, 0x3f, 0x00, 0x00,
    0x80, 0x3f, 0x00, 0x00, 0x00, 0xff, 0x00, 0x00, 0x00, 0xfe, 0x00, 0x00, 0x00, 0xfc, 0x03, 0x00,
    0x00, 0xf8, 0x07, 0x00, 0x00, 0xf0, 0x0f, 0x00, 0x00, 0xe0, 0x1f, 0x00, 0x00, 0xc0, 0x3f, 0x00,
    0x00, 0x80, 0x3f, 0x00, 0x00, 0x00, 0xff, 0x00, 0x00, 0x00, 0xfe, 0x00, 0x00, 0x00, 0xfc, 0x03,
    0x00, 0x00, 0xf8, 0x07, 0x00, 0x00, 0xf0, 0x0f, 0x00, 0x00, 0xe0, 0x1f, 0x00, 0x00, 0xc0, 0x1f,
};

static inline bool phase5_pair_is_sync(uint8_t previous, uint8_t current)
{
    unsigned index = ((unsigned)previous << 5u) | current;
    return (s_phase5_sync_mask[index >> 3u] & (1u << (index & 7u))) != 0u;
}

static inline unsigned trajectory_v2_stage1_address(uint8_t previous_phase5,
                                                    uint8_t middle_raw,
                                                    uint8_t current_raw)
{
    /* Must mirror fm_traj.bsasm exactly:
     *   A0..A7 = current raw Q4/I4
     *   A8     = middle raw-I sign
     *   A9     = previous actual Phase5 MSB. */
    return (unsigned)current_raw |
           ((((unsigned)middle_raw >> 7u) & 1u) << 8u) |
           ((((unsigned)previous_phase5 >> 4u) & 1u) << 9u);
}

static inline unsigned trajectory_v2_stage2_address(uint8_t previous_phase5,
                                                    uint8_t token)
{
    return (unsigned)previous_phase5 | (((unsigned)token & 31u) << 5u);
}

static inline uint8_t trajectory_v2_code(uint8_t previous_phase5,
                                         uint8_t middle_raw,
                                         uint8_t current_raw)
{
    unsigned stage1 =
        trajectory_v2_stage1_address(previous_phase5, middle_raw, current_raw);
    uint8_t token = c5vrx_trajectory_v2_token[stage1];
    return c5vrx_trajectory_v2_dac[
        trajectory_v2_stage2_address(previous_phase5, token)];
}

static inline fusion_shadow_metrics_t active_demod_shadow(fusion_shadow_metrics_t shadow)
{
    /* Compressed-LUT ambiguity is only a live failure mechanism when TRAJ V2
     * is actually selected. Keep GOLDEN A/B behavior free of this extra
     * penalty; generic raw-IQ/PLL-lite evidence remains active in both modes. */
    if (s_demod_mode != DEMOD_MODE_TRAJECTORY_V2)
        shadow.trajectory_uncertainty_permille = 0;
    return shadow;
}

static uint32_t s_receive_generation;

static void video_standard_detector_reset(void)
{
    ++s_receive_generation;
    s_video_std_pal_score = 0;
    s_video_std_ntsc_score = 0;
    s_detected_video_std_valid = false;
    s_last_line_period_20m = 0;
    s_last_sync_width_20m = 0;
    s_last_sync_quality = 0;
}

static void video_standard_vote(video_standard_t standard, uint16_t period)
{
    s_last_line_period_20m = period;
    if (standard == VIDEO_STD_PAL) {
        if (s_video_std_pal_score < 8u) ++s_video_std_pal_score;
        if (s_video_std_ntsc_score) --s_video_std_ntsc_score;
    } else {
        if (s_video_std_ntsc_score < 8u) ++s_video_std_ntsc_score;
        if (s_video_std_pal_score) --s_video_std_pal_score;
    }

    if (s_video_std_pal_score >= 3u &&
        s_video_std_pal_score >= s_video_std_ntsc_score + 2u) {
        s_detected_video_std = VIDEO_STD_PAL;
        s_detected_video_std_valid = true;
    } else if (s_video_std_ntsc_score >= 3u &&
               s_video_std_ntsc_score >= s_video_std_pal_score + 2u) {
        s_detected_video_std = VIDEO_STD_NTSC;
        s_detected_video_std_valid = true;
    }
}

/* Observe one complete, stable RX descriptor. Production Phase5 consumes the
 * odd byte of each 16-bit read, so this mirrors the same 20 MS/s sample
 * cadence. Valid H-sync low runs are about 94 samples wide. Their start-to-
 * start period is ~1271 samples for NTSC and exactly 1280 for PAL. */
static int video_semantic_observe(const uint8_t *raw, size_t bytes, size_t ring_offset)
{
    if (!raw || bytes < 3000u) return 0;

    const size_t first = (ring_offset & 1u) ? 0u : 1u;
    if (first + 2u >= bytes) return 0;

    uint8_t previous = s_phase5_state_lut[raw[first]];
    bool in_sync = false;
    unsigned run_start = 0;
    unsigned run_len = 0;
    unsigned starts[4];
    unsigned widths[4];
    unsigned start_count = 0;
    unsigned out_index = 1;

    for (size_t i = first + 2u; i < bytes; i += 2u, ++out_index) {
        uint8_t current = s_phase5_state_lut[raw[i]];
        bool low = s_demod_mode == DEMOD_MODE_TRAJECTORY_V2 ?
                   trajectory_v2_code(previous, raw[i - 1u], raw[i]) <= 8u :
                   phase5_pair_is_sync(previous, current);
        previous = current;

        if (low) {
            if (!in_sync) {
                in_sync = true;
                run_start = out_index;
                run_len = 1u;
            } else {
                ++run_len;
            }
        } else if (in_sync) {
            /* Real horizontal sync is ~94 samples at 20 MS/s.  Keep the broad
             * physical acceptance window for robustness, but score closeness
             * to the real pulse width instead of treating every accepted low
             * run as equally convincing. */
            if (run_len >= 70u && run_len <= 125u && start_count < 4u) {
                starts[start_count] = run_start;
                widths[start_count] = run_len;
                ++start_count;
            }
            in_sync = false;
            run_len = 0u;
        }
    }

    unsigned width_error_sum = 0;
    for (unsigned i = 0; i < start_count; ++i) {
        unsigned w = widths[i];
        width_error_sum += w > 94u ? w - 94u : 94u - w;
    }
    unsigned width_error = start_count ? width_error_sum / start_count : 100u;
    int width_score = start_count ? 40 - (int)width_error * 4 : 0;
    if (width_score < 0) width_score = 0;
    s_last_sync_width_20m = start_count ? (uint16_t)widths[0] : 0u;

    int best_period_score = 0;
    bool valid_period = false;
    for (unsigned i = 1; i < start_count; ++i) {
        unsigned period = starts[i] - starts[i - 1u];
        int score = 0;

        if (period >= 1266u && period <= 1275u) {
            unsigned error = period > 1271u ? period - 1271u : 1271u - period;
            score = 60 - (int)error * 8;
            valid_period = true;
            video_standard_vote(VIDEO_STD_NTSC, (uint16_t)period);
        } else if (period >= 1277u && period <= 1284u) {
            unsigned error = period > 1280u ? period - 1280u : 1280u - period;
            score = 60 - (int)error * 8;
            valid_period = true;
            video_standard_vote(VIDEO_STD_PAL, (uint16_t)period);
        }
        if (score > best_period_score) best_period_score = score;
    }

    /* A lone random low pulse can earn at most 40/100.  TRACK/acquisition
     * requires >=60, which means a physically plausible repeated line period
     * must also be present. */
    int quality = width_score + best_period_score;
    if (!valid_period) quality = width_score;
    if (quality > 100) quality = 100;
    s_last_sync_quality = quality;
    return quality;
}

typedef struct {
    int p_median;
    int q_phase;
    int n_clip;
    int n_origin;
    int clip_permille;
    int origin_permille;
    int n_coherent;
    int sum_cross;
    int sum_dot;
    int sum_i;
    int sum_q;
    int sum_i2;
    int sum_q2;
    int sum_iq;
    int dc_i_x100;
    int dc_q_x100;
    int iq_skew_permille;
    int iq_cross_permille;
    int winding_events;
    int winding_triplets;
    int winding_permille;
    int strong_winding_events;
    int strong_winding_triplets;
    int strong_winding_permille;
    uint32_t trajectory_uncertainty_sum;
    uint32_t trajectory_states;
    fusion_shadow_metrics_t fusion_shadow;
} control_metrics_t;

static control_metrics_t analyze_control_window(const uint8_t *sample, size_t bytes,
                                                size_t ring_offset)
{
    control_metrics_t m = {0};
    uint16_t hist[129] = {0};
    const size_t production_first = (ring_offset & 1u) ? 0u : 1u;
    int8_t prev_i = 0, prev_q = 0;
    uint8_t prev_phase = 0, prev2_phase = 0;
    uint8_t prev_byte = 0;
    int prev_power = 0, prev2_power = 0;
    fusion_shadow_t fusion_shadow;
    fusion_shadow_reset(&fusion_shadow);

    for (size_t i = 0; i < bytes; ++i) {
        uint8_t byte = sample[i];
        int8_t q = (int8_t)((byte & 0x0fu) << 4) >> 4;
        int8_t in_val = (int8_t)(byte & 0xf0u) >> 4;

        if (in_val == -8 || in_val == 7 || q == -8 || q == 7) ++m.n_clip;
        int i2 = (int)in_val * in_val;
        int q2 = (int)q * q;
        m.sum_i += in_val;
        m.sum_q += q;
        m.sum_i2 += i2;
        m.sum_q2 += q2;
        m.sum_iq += (int)in_val * q;

        int p = i2 + q2;
        const int raw_power = p;
        const uint8_t phase = s_phase5_state_lut[byte];
        fusion_shadow_push(&fusion_shadow, phase, raw_power);
        if (p <= 4) ++m.n_origin;
        if (p > 128) p = 128;
        ++hist[p];

        if (i > 0) {
            int dot = (int)in_val * (int)prev_i + (int)q * (int)prev_q;
            int cross = (int)q * (int)prev_i - (int)in_val * (int)prev_q;
            int abs_cross = cross < 0 ? -cross : cross;
            if (p >= 8 && dot > 0 && abs_cross <= dot) {
                ++m.n_coherent;
                m.sum_cross += cross;
                m.sum_dot += dot;
            }
        }

        /* fm.bsasm consumes one parity at 20 MS/s. Count exactly those
         * endpoint intervals, while using the skipped 40 MS/s middle sample
         * only as a shadow oracle. */
        bool production_endpoint =
            i >= production_first + 2u &&
            ((i - production_first) & 1u) == 0u;
        if (production_endpoint) {
            bool winding = demod_phase5_endpoint_loses_winding(prev2_phase,
                                                               prev_phase,
                                                               phase);
            ++m.winding_triplets;
            if (winding) ++m.winding_events;
            if (prev2_power >= DEMOD_STRONG_POWER_MIN &&
                prev_power >= DEMOD_STRONG_POWER_MIN &&
                raw_power >= DEMOD_STRONG_POWER_MIN) {
                ++m.strong_winding_triplets;
                if (winding) ++m.strong_winding_events;
            }

            unsigned traj_addr =
                trajectory_v2_stage1_address(prev2_phase, prev_byte, byte);
            m.trajectory_uncertainty_sum +=
                255u - c5vrx_trajectory_v2_confidence[traj_addr];
            ++m.trajectory_states;
        }

        prev2_phase = prev_phase;
        prev_phase = phase;
        prev2_power = prev_power;
        prev_power = raw_power;
        prev_byte = byte;
        prev_i = in_val;
        prev_q = q;
    }

    unsigned cumulative = 0;
    for (unsigned p = 0; p <= 128u; ++p) {
        cumulative += hist[p];
        if (cumulative >= (bytes + 1u) / 2u) {
            m.p_median = (int)p;
            break;
        }
    }
    m.q_phase = bytes > 1u ? (m.n_coherent * 100) / (int)(bytes - 1u) : 0;
    m.clip_permille = bytes ? (m.n_clip * 1000) / (int)bytes : 0;
    m.origin_permille = bytes ? (m.n_origin * 1000) / (int)bytes : 1000;
    m.winding_permille = m.winding_triplets ?
        (m.winding_events * 1000) / m.winding_triplets : 0;
    m.strong_winding_permille = m.strong_winding_triplets ?
        (m.strong_winding_events * 1000) / m.strong_winding_triplets : 0;
    m.dc_i_x100 = bytes ? (m.sum_i * 100) / (int)bytes : 0;
    m.dc_q_x100 = bytes ? (m.sum_q * 100) / (int)bytes : 0;

    /* These two dimensionless metrics are intentionally cheap. A perfect
     * centered/circular I/Q cloud tends toward zero skew and zero I/Q cross
     * correlation. They let us quantify DC/IQ calibration quality without
     * putting any new calibration routine in the realtime path. */
    int iq_power = m.sum_i2 + m.sum_q2;
    if (iq_power > 0) {
        int skew = m.sum_i2 - m.sum_q2;
        if (skew < 0) skew = -skew;
        int cross = m.sum_iq;
        if (cross < 0) cross = -cross;
        m.iq_skew_permille = (skew * 1000) / iq_power;
        m.iq_cross_permille = (cross * 2000) / iq_power;
    }
    m.fusion_shadow = fusion_shadow_finish(&fusion_shadow);
    if (m.trajectory_states) {
        m.fusion_shadow.trajectory_uncertainty_permille =
            (int)((m.trajectory_uncertainty_sum * 1000u) /
                  (m.trajectory_states * 255u));
    }
    return m;
}

/* Fast observer publishes temporal state with a tiny sequence lock. It only
 * reads completed DMA data; the 40 MS/s hardware path never waits on it. */
static volatile uint32_t s_fusion_temporal_seq;
static fusion_temporal_metrics_t s_fusion_temporal_shared;

static fusion_temporal_metrics_t fusion_temporal_read_shared(void)
{
    fusion_temporal_metrics_t out = {0};
    for (unsigned retry = 0; retry < 4u; ++retry) {
        uint32_t before = s_fusion_temporal_seq;
        if (before & 1u) continue;
        __sync_synchronize();
        out = s_fusion_temporal_shared;
        __sync_synchronize();
        uint32_t after = s_fusion_temporal_seq;
        if (before == after && !(after & 1u)) return out;
    }
    return out;
}

static void fusion_temporal_publish(const fusion_temporal_metrics_t *m)
{
    ++s_fusion_temporal_seq;
    __sync_synchronize();
    s_fusion_temporal_shared = *m;
    __sync_synchronize();
    ++s_fusion_temporal_seq;
}

/* Distributed observation closes a major blind spot in the old controller:
 * one 102 us descriptor every 50 ms observed only ~0.2% of RF time. This task
 * spreads similarly small CPU reads across the interval. It never writes PHY
 * state and never participates in DMA pacing. */
static void fusion_observer_task(void *arg)
{
    (void)arg;
    fusion_temporal_t temporal;
    fusion_temporal_reset(&temporal);
    uint32_t seen_generation = s_profile_generation;
    uint8_t sample[FUSION_FAST_SAMPLE_BYTES];

    for (;;) {
        vTaskDelay(pdMS_TO_TICKS(FUSION_FAST_PERIOD_MS));

        if (seen_generation != s_profile_generation) {
            seen_generation = s_profile_generation;
            fusion_temporal_reset(&temporal);
        }

        uint8_t *src = get_completed_rx_sample_window(sizeof(sample));
        size_t ring_offset =
            (src >= s_raw_ring && src < s_raw_ring + sizeof(s_raw_ring)) ?
            (size_t)(src - s_raw_ring) : 0u;
        sync_dma_m2c((void *)src, sizeof(sample));
        memcpy(sample, src, sizeof(sample));

        control_metrics_t metrics =
            analyze_control_window(sample, sizeof(sample), ring_offset);
        fusion_observation_t obs = fusion_make_observation(
            metrics.p_median, metrics.q_phase, metrics.clip_permille,
            metrics.origin_permille, metrics.winding_permille,
            metrics.strong_winding_permille, metrics.iq_skew_permille,
            metrics.iq_cross_permille, s_last_sync_quality,
            active_demod_shadow(metrics.fusion_shadow));
        fusion_temporal_metrics_t tm = fusion_temporal_update(&temporal, &obs);
        fusion_temporal_publish(&tm);
    }
}

/* =========================================================================
 * Receiver Modes, Slow-Transition AGC, Fixed BW40, and AFC State
 *
 * The physical actuator still evaluates one complete 4092-byte descriptor
 * every 50 ms, while a separate 512-byte shadow observer samples every 6 ms
 * to estimate fades/recovery without increasing PHY writes. TRACK performs
 * zero gain writes.
 *
 * SEARCH requires phase coherence; power alone is not accepted as a carrier.
 * With no lock it slowly probes G52/G62 instead of parking at maximum gain.
 * LEARN uses +2/-2 normal steps with persistence.  Only severe clipping may
 * issue a bounded -4 emergency cut.  Every physical gain write is followed by
 * a 500 ms decision hold and deliberately emits no serial output.
 *
 * The same settled descriptor can vote PAL/NTSC line period for AUTO menu
 * matching; this observation never replaces or stalls the live Phase5 path.
 *
 * Modes:
 *   - ANALOG_AGC_SHADOW: realtime state machine, physical gain frozen.
 *   - ANALOG_AGC_ACTIVE: default production controller.
 *   - ANALOG_AGC_MANUAL: fixed gain controlled by user (+ / - keys).
 * ========================================================================= */

typedef enum {
    ANALOG_AGC_SHADOW = 0,
    ANALOG_AGC_ACTIVE = 1,
    ANALOG_AGC_MANUAL = 2,
} analog_agc_mode_t;

typedef enum {
    AGC_STATE_SEARCH = 0,
    AGC_STATE_LEARN  = 1,
    AGC_STATE_TRACK  = 2,
} agc_state_t;

typedef enum {
    AFC_MODE_AUTO = 0, /* Auto Carrier Centering: centers within safe +/-1.5 MHz bound when locked */
    AFC_MODE_HOLD = 1, /* AFC Hold: freeze current offset */
    AFC_MODE_OFF  = 2, /* AFC Off: reset to 0 kHz offset */
} afc_mode_t;

static const char *rx_profile_name(void)
{
    switch (s_rx_profile) {
    case RX_PROFILE_RANGE_EXP:    return "RANGE EXP";
    case RX_PROFILE_BLOCKER_EXP:  return "BLOCKER EXP";
    case RX_PROFILE_RECOVERY_EXP: return "RECOVERY";
    case RX_PROFILE_AUTO_EXP:     return "AUTO EXP";
    case RX_PROFILE_ARC:          return "ARC";
    case RX_PROFILE_FUSION_EXP:   return "FUSION EXP";
    case RX_PROFILE_RANGE_V2_EXP:return "RANGE V2";
    case RX_PROFILE_ARC_V3_EXP:  return "ARC V3 EXP";
    case RX_PROFILE_ARC_V5_AUTOTUNE_EXP: return "ARC V5 AUTOTUNE";
    default:                     return "BALANCED";
    }
}

static uint8_t profile_gain_min(void)
{
    switch (s_rx_profile) {
    case RX_PROFILE_RANGE_EXP:   return 2u; /* Allow recovery from a nearby strong VTX. */
    case RX_PROFILE_BLOCKER_EXP: return 8u;
    case RX_PROFILE_RECOVERY_EXP:return 20u;
    case RX_PROFILE_FUSION_EXP:  return 34u;
    case RX_PROFILE_RANGE_V2_EXP:return 2u;
    default:                     return 2u;
    }
}

static uint8_t profile_gain_max(void)
{
    switch (s_rx_profile) {
    case RX_PROFILE_BLOCKER_EXP: return 48u;
    case RX_PROFILE_ARC:
    case RX_PROFILE_ARC_V3_EXP:
    case RX_PROFILE_ARC_V5_AUTOTUNE_EXP: return rf_get_arc_gain_table()->max_index;
    default:                     return 62u;
    }
}

static uint8_t profile_gain_clamp(int gain)
{
    int lo = profile_gain_min();
    int hi = profile_gain_max();
    if (gain < lo) gain = lo;
    if (gain > hi) gain = hi;
    return (uint8_t)gain;
}

static unsigned profile_search_probe_ticks(void)
{
    switch (s_rx_profile) {
    case RX_PROFILE_RANGE_EXP:    return 12u; /* 600 ms */
    case RX_PROFILE_RECOVERY_EXP: return 6u;  /* 300 ms */
    case RX_PROFILE_AUTO_EXP:     return 8u;  /* 400 ms */
    case RX_PROFILE_BLOCKER_EXP:  return 12u;
    default:                      return GAIN_SEARCH_PROBE_TICKS;
    }
}

static unsigned profile_weak_persistence(void)
{
    switch (s_rx_profile) {
    case RX_PROFILE_RANGE_EXP:    return 3u;
    case RX_PROFILE_RECOVERY_EXP: return 2u;
    case RX_PROFILE_AUTO_EXP:     return 3u;
    default:                      return 5u;
    }
}

static const char *rf_bw_mode_name(void)
{
    return s_rf_bw_mode == RF_BW_MODE_BW40 ? "BW40" :
           s_rf_bw_mode == RF_BW_MODE_BW20 ? "BW20" : "AUTO EXP";
}

static const char *output_mode_name(void)
{
    return s_output_mode == VIDEO_OUTPUT_4BIT_80 ? "4BIT@80" : "6BIT@40";
}

static const char *demod_mode_name(void)
{
    return s_demod_mode == DEMOD_MODE_TRAJECTORY_V2 ? "TRAJ V2" : "GOLDEN";
}

static void cycle_demod_mode(void)
{
    s_demod_mode = s_demod_mode == DEMOD_MODE_GOLDEN_PHASE5 ?
                   DEMOD_MODE_TRAJECTORY_V2 : DEMOD_MODE_GOLDEN_PHASE5;
    /* TRAJ V2 and 4BIT@80 use different BitScrambler/output contracts.
     * Selecting TRAJ V2 therefore moves the DAC back to its proven 6-bit path.
     * The inverse action is handled on the DAC control: selecting 4BIT@80
     * automatically returns to GOLDEN instead of making 4-bit unreachable. */
    if (s_demod_mode == DEMOD_MODE_TRAJECTORY_V2)
        s_output_mode = VIDEO_OUTPUT_6BIT_40;

    /* Semantic sync interpretation changes with the demod LUT. Do not carry
     * PAL/NTSC votes or lock age from the previous demodulator across an A/B
     * switch. receive_generation also makes the controller relearn cleanly. */
    video_standard_detector_reset();
    ++s_profile_generation; /* reset Fusion temporal/optimizer state for clean A/B */
}

static void apply_rf_bandwidth(bool bw40)
{
    s_last_phy_write_us = esp_timer_get_time();
    s_last_phy_write_kind = PHY_WRITE_BW;
    s_current_bw40 = bw40;
    rf_set_analog_bandwidth(bw40);
}

static void cycle_rf_bandwidth_mode(void)
{
    if (s_rf_bw_mode == RF_BW_MODE_BW40) {
        s_rf_bw_mode = RF_BW_MODE_BW20;
        apply_rf_bandwidth(false);
    } else if (s_rf_bw_mode == RF_BW_MODE_BW20) {
        s_rf_bw_mode = RF_BW_MODE_AUTO;
        apply_rf_bandwidth(true); /* AUTO always enters in high gear. */
    } else {
        s_rf_bw_mode = RF_BW_MODE_BW40;
        apply_rf_bandwidth(true);
    }
}

static volatile analog_agc_mode_t s_agc_mode = ANALOG_AGC_ACTIVE;
static volatile agc_state_t s_agc_state = AGC_STATE_SEARCH;
/* WBFM instantaneous phase slope contains the video modulation itself.
 * The short-window CFO estimator is useful diagnostics, but it is not yet a
 * calibrated LO-error estimator. Never retune automatically at boot. */
static volatile afc_mode_t s_afc_mode = AFC_MODE_OFF;
static volatile uint8_t s_current_gain = 62u;   /* Physical RF gain applied */
static volatile uint8_t s_shadow_gain = 62u;    /* Controller recommended gain */
static volatile int s_last_p_median = 25;
static volatile int s_last_q_phase = 0;
static volatile int s_signal_strength = 0;
static volatile int s_last_n_clip = 0;
static volatile int s_last_n_origin = 0;
static volatile int s_last_clip_permille = 0;
static volatile int s_last_origin_permille = 0;
static volatile int s_last_dc_i_x100 = 0;
static volatile int s_last_dc_q_x100 = 0;
static volatile int s_last_iq_skew_permille = 0;
static volatile int s_last_iq_cross_permille = 0;
static volatile int s_last_winding_permille = 0;
static volatile int s_last_strong_winding_permille = 0;
static volatile int s_last_fusion_quality = 0;
static volatile int s_last_fusion_confidence = 0;
static volatile int s_last_fusion_context = FUSION_CONTEXT_NO_CARRIER;
static volatile int s_last_fusion_low_confidence_pm = 0;
static volatile int s_last_fusion_lag2_pm = 0;
static volatile int s_last_fusion_lag4_pm = 0;
static volatile int s_last_fusion_consensus_pm = 0;
static volatile int s_last_fusion_slope_x100 = 0;
static volatile int s_last_trajectory_uncertainty_pm = 0;
static volatile int s_last_pll_lite_slip_pm = 0;
static volatile int s_last_pll_lite_hold_pm = 0;
static volatile int s_last_fusion_risk = 0;
static volatile int s_last_fusion_fade = 0;
static volatile int s_last_fusion_recovery = 0;
static volatile int s_last_fusion_stability = 0;
static volatile uint32_t s_last_fusion_fast_samples = 0;

static volatile uint32_t s_gain_transition_count = 0;
static volatile int s_cfo_khz = 0;              /* Carrier Frequency Offset in kHz */
static volatile bool s_channel_scan_active;
static volatile unsigned s_channel_scan_progress;

/* Issue #27/#28 lab characterization is deliberately console-driven and
 * opt-in. It never paces the realtime IQ/CVBS path and adds no periodic task. */
typedef struct {
    bool active;
    bool sampled;
    uint8_t gain;
    uint8_t saved_gain;
    uint8_t saved_shadow_gain;
    analog_agc_mode_t saved_agc_mode;
    agc_state_t saved_agc_state;
    rf_bw_mode_t saved_bw_mode;
    bool saved_bw40;
    afc_mode_t saved_afc_mode;
    int saved_offset_khz;
    bool saved_quiet;
    int64_t applied_us;
    hw_transport_counters_t step_base;
} lab_gain_sweep_t;

static lab_gain_sweep_t s_gain_sweep;
static volatile bool s_lab_quiet;
static volatile bool s_lab_fft_forced;
static volatile int8_t s_lab_fft_value;
static volatile bool s_lab_tx_quiet;
static volatile bool s_pre_q4_probe_active;

static const int8_t s_lab_fft_values[] = {16, 24, 32, 40};

#define SETTINGS_VERSION 4u
#define SETTINGS_NAMESPACE "c5vrx"
#define SETTINGS_KEY "settings"

typedef struct {
    uint8_t version;
    uint8_t channel_index;
    uint8_t rf_bw_mode;
    uint8_t afc_mode;
    uint8_t output_mode;
    uint8_t video_std_mode;
    uint8_t agc_mode;
    uint8_t manual_gain;
    int16_t frequency_offset_khz;
    uint8_t menu_boot_btn_enabled;
    uint8_t rx_profile;
    uint8_t demod_mode;
    uint8_t reserved[1];
} persisted_settings_t;

/* v4 deliberately consumes one of v3's two reserved bytes for demod_mode.
 * Keep the blob byte-for-byte the same size so a v3 record can be migrated
 * safely with DEMOD_MODE_GOLDEN_PHASE5. */
_Static_assert(sizeof(persisted_settings_t) == 14u,
               "settings v3/v4 migration layout changed");

/* Frequency-offset writes in rf.c re-assert the current forced RX gain after
 * touching the PHY channel offset. Track that hidden gain write so issue #28
 * correlation does not incorrectly call an AFC/fine-tune transient unrelated. */
static void apply_frequency_offset_khz_tracked(int offset_khz)
{
    int64_t now = esp_timer_get_time();
    s_last_gain_write_us = now; /* rf.c re-asserts the forced RX gain */
    s_last_phy_write_us = now;
    s_last_phy_write_kind = PHY_WRITE_OFFSET;
    rf_set_frequency_offset_khz(offset_khz);
    ++s_gain_transition_count;
}

static void step_frequency_offset_khz_tracked(int delta_khz)
{
    apply_frequency_offset_khz_tracked(rf_get_frequency_offset_khz() + delta_khz);
}

static void apply_rx_gain_tracked(uint8_t gain)
{
    gain = profile_gain_clamp(gain);
    s_current_gain = gain;
    s_shadow_gain = gain;
    s_last_gain_write_us = esp_timer_get_time();
    s_last_phy_write_us = s_last_gain_write_us;
    s_last_phy_write_kind = PHY_WRITE_GAIN;
    rf_set_rx_gain(true, gain);
    ++s_gain_transition_count;
}

static int signal_strength_score(const control_metrics_t *m, uint8_t gain)
{
    if (m->q_phase < 18 || m->origin_permille > 850) return 0;
    int coherence = (m->q_phase - 18) * 100 / 62;
    int power = (m->p_median - 6) * 100 / 28;
    int max_gain = profile_gain_max();
    int gain_headroom = (max_gain - (int)gain) * 100 /
                        (max_gain > 2 ? max_gain - 2 : 1);
    if (coherence < 0) coherence = 0; else if (coherence > 100) coherence = 100;
    if (power < 0) power = 0; else if (power > 100) power = 100;
    if (gain_headroom < 0) gain_headroom = 0; else if (gain_headroom > 100) gain_headroom = 100;
    return (coherence * 2 + power + gain_headroom) / 4;
}

static void settings_save(void)
{
    persisted_settings_t settings = {
        .version = SETTINGS_VERSION,
        .channel_index = (uint8_t)rf_get_channel_index(),
        .rf_bw_mode = (uint8_t)s_rf_bw_mode,
        .afc_mode = (uint8_t)s_afc_mode,
        .output_mode = (uint8_t)s_output_mode,
        .video_std_mode = (uint8_t)s_video_std_mode,
        .agc_mode = (uint8_t)s_agc_mode,
        .manual_gain = s_current_gain,
        .frequency_offset_khz = (int16_t)rf_get_frequency_offset_khz(),
        .menu_boot_btn_enabled = s_menu_boot_btn_enabled ? 1u : 0u,
        .rx_profile = (uint8_t)s_rx_profile,
        .demod_mode = (uint8_t)s_demod_mode,
    };
    nvs_handle_t handle;
    esp_err_t err = nvs_open(SETTINGS_NAMESPACE, NVS_READWRITE, &handle);
    if (err == ESP_OK) {
        err = nvs_set_blob(handle, SETTINGS_KEY, &settings, sizeof(settings));
        if (err == ESP_OK) err = nvs_commit(handle);
        nvs_close(handle);
    }
    if (err != ESP_OK) ESP_LOGW(TAG, "Could not save settings: %s", esp_err_to_name(err));
}

static void settings_load(void)
{
    persisted_settings_t settings = {0};
    size_t length = sizeof(settings);
    nvs_handle_t handle;
    esp_err_t err = nvs_open(SETTINGS_NAMESPACE, NVS_READONLY, &handle);
    if (err == ESP_OK) {
        err = nvs_get_blob(handle, SETTINGS_KEY, &settings, &length);
        nvs_close(handle);
    }
    bool legacy_v3 = settings.version == 3u;
    if (err != ESP_OK || length != sizeof(settings) ||
        (!legacy_v3 && settings.version != SETTINGS_VERSION)) {
        s_rx_profile = RX_PROFILE_ARC;
        s_demod_mode = DEMOD_MODE_GOLDEN_PHASE5;
        s_rf_bw_mode = RF_BW_MODE_BW40;
        s_afc_mode = AFC_MODE_OFF;
        s_agc_mode = ANALOG_AGC_ACTIVE;
        s_current_gain = rf_get_arc_survival_gain();
        s_shadow_gain = s_current_gain;
        apply_rf_bandwidth(true);
        rf_set_rx_gain(true, s_current_gain);
        return;
    }

    if (settings.channel_index < rf_get_channel_count()) (void)rf_set_channel(settings.channel_index);
    if (settings.rf_bw_mode <= RF_BW_MODE_AUTO) s_rf_bw_mode = (rf_bw_mode_t)settings.rf_bw_mode;
    apply_rf_bandwidth(s_rf_bw_mode != RF_BW_MODE_BW20);
    if (settings.afc_mode <= AFC_MODE_OFF) s_afc_mode = (afc_mode_t)settings.afc_mode;
    if (settings.output_mode <= VIDEO_OUTPUT_4BIT_80) s_output_mode = (video_output_mode_t)settings.output_mode;
    /* v3 used this exact byte as zero-initialized reserved storage, so old
     * Range-v2 settings migrate losslessly with the proven GOLDEN demod. */
    if (legacy_v3) {
        s_demod_mode = DEMOD_MODE_GOLDEN_PHASE5;
    } else if (settings.demod_mode < DEMOD_MODE_COUNT) {
        s_demod_mode = (demod_mode_t)settings.demod_mode;
    }
    if (s_demod_mode == DEMOD_MODE_TRAJECTORY_V2) s_output_mode = VIDEO_OUTPUT_6BIT_40;
    if (settings.video_std_mode <= VIDEO_STD_MODE_PAL) s_video_std_mode = (video_standard_mode_t)settings.video_std_mode;
    if (settings.rx_profile < RX_PROFILE_COUNT) {
        s_rx_profile = (rx_profile_t)settings.rx_profile;
    } else {
        s_rx_profile = RX_PROFILE_RANGE_EXP;
    }
    if (s_rx_profile == RX_PROFILE_RANGE_EXP ||
        s_rx_profile == RX_PROFILE_FUSION_EXP ||
        s_rx_profile == RX_PROFILE_ARC ||
        s_rx_profile == RX_PROFILE_ARC_V3_EXP ||
        s_rx_profile == RX_PROFILE_ARC_V5_AUTOTUNE_EXP) {
        /* RANGE/FUSION have one deterministic RF shape across reboot: the
         * proven full-video filter, with no acquisition-time filter or AFC writes. */
        s_rf_bw_mode = RF_BW_MODE_BW40;
        s_afc_mode = AFC_MODE_OFF;
        apply_rf_bandwidth(true);
    } else if (s_rx_profile == RX_PROFILE_RANGE_V2_EXP) {
        /* RANGE V2 always boots from the proven full-video shape, then permits
         * BW/AFC changes only while acquiring/relearning. Persisted menu fields
         * must not silently turn it into a different controller after reboot. */
        s_rf_bw_mode = RF_BW_MODE_AUTO;
        s_afc_mode = AFC_MODE_AUTO;
        apply_rf_bandwidth(true);
    }
    if (s_video_std_mode == VIDEO_STD_MODE_PAL) s_video_std = VIDEO_STD_PAL;
    else if (s_video_std_mode == VIDEO_STD_MODE_NTSC) s_video_std = VIDEO_STD_NTSC;
    if (settings.agc_mode <= ANALOG_AGC_MANUAL) s_agc_mode = (analog_agc_mode_t)settings.agc_mode;
    if (s_agc_mode == ANALOG_AGC_MANUAL && settings.manual_gain >= 2u && settings.manual_gain <= 62u) {
        s_current_gain = profile_gain_clamp(settings.manual_gain);
    } else {
        switch (s_rx_profile) {
        case RX_PROFILE_RANGE_EXP:    s_current_gain = 62u; break;
        case RX_PROFILE_BLOCKER_EXP:  s_current_gain = 36u; break;
        case RX_PROFILE_RECOVERY_EXP: s_current_gain = 52u; break;
        case RX_PROFILE_AUTO_EXP:     s_current_gain = 52u; break;
        case RX_PROFILE_FUSION_EXP:   s_current_gain = 62u; break;
        case RX_PROFILE_RANGE_V2_EXP: s_current_gain = 62u; break;
        case RX_PROFILE_ARC:          s_current_gain = rf_get_arc_survival_gain(); break;
        case RX_PROFILE_ARC_V3_EXP:   s_current_gain = rf_get_arc_survival_gain(); break;
        case RX_PROFILE_ARC_V5_AUTOTUNE_EXP: s_current_gain = rf_get_arc_survival_gain(); break;
        default:                      s_current_gain = 52u; break;
        }
        s_current_gain = profile_gain_clamp(s_current_gain);
    }
    s_shadow_gain = s_current_gain;
    rf_set_rx_gain(true, s_current_gain);
    s_menu_boot_btn_enabled = settings.menu_boot_btn_enabled != 0;
    if (s_afc_mode == AFC_MODE_HOLD) apply_frequency_offset_khz_tracked(settings.frequency_offset_khz);
    else if (s_afc_mode == AFC_MODE_OFF) apply_frequency_offset_khz_tracked(0);
    ESP_LOGI(TAG, "Restored settings%s: channel=%u profile=%s BW=%s output=%s demod=%s",
             legacy_v3 ? " (v3 migrated)" : "",
             settings.channel_index, rx_profile_name(), rf_bw_mode_name(),
             output_mode_name(), demod_mode_name());
}

static void record_transport_event(uint32_t flags)
{
    if (!flags) return;
    int64_t now = esp_timer_get_time();
    uint32_t seq = s_lag_event_head + 1u;
    unsigned index = (seq - 1u) % LAG_EVENT_LOG_SIZE;
    uint32_t rx_off = get_rx_dma_offset(NULL);
    uint32_t tx_off = get_tx_dma_offset(NULL);

    s_lag_events[index] = (lag_event_t) {
        .time_us = now,
        .seq = seq,
        .flags = flags,
        .rx_off = (uint16_t)rx_off,
        .tx_off = (uint16_t)tx_off,
        .gain = s_current_gain,
        .agc_state = (uint8_t)s_agc_state,
    };
    s_lag_event_head = seq;
    s_last_transport_event_us = now;
    s_last_transport_flags = flags;
    ++s_hw_counters.lag_event_count;

    if (s_last_gain_write_us > 0) {
        int64_t dt = now - s_last_gain_write_us;
        if (dt >= 0 && dt <= 200000) ++s_hw_counters.near_gain_event_count;
    }
    if (s_last_phy_write_us > 0) {
        int64_t dt = now - s_last_phy_write_us;
        if (dt >= 0 && dt <= 200000) ++s_hw_counters.near_phy_event_count;
    }
}

static void poll_transport_faults(void)
{
    uint32_t flags = 0;
    bool tx_rempty = PARL_IO.int_raw.tx_fifo_rempty_int_raw != 0;

    if (tx_rempty) {
        ++s_hw_counters.parl_tx_rempty_count;
        PARL_IO.int_clr.tx_fifo_rempty_int_clr = 1;
        flags |= LAG_EVT_PARLIO_TX_REMPTY;
    }
    if (PARL_IO.int_raw.rx_fifo_wovf_int_raw) {
        ++s_hw_counters.parl_rx_wovf_count;
        PARL_IO.int_clr.rx_fifo_wovf_int_clr = 1;
        flags |= LAG_EVT_PARLIO_RX_WOVF;
    }
    if (PARL_IO.int_raw.tx_eof_int_raw) {
        ++s_hw_counters.parl_tx_eof_count;
        PARL_IO.int_clr.tx_eof_int_clr = 1;
        flags |= LAG_EVT_PARLIO_TX_EOF;
    }

    if (s_rx_dma_ch >= 0 && s_rx_dma_ch < 3) {
        uint32_t raw = AHB_DMA.in_intr[s_rx_dma_ch].raw.val & GDMA_IN_FAULT_MASK;
        if (raw) {
            ++s_hw_counters.gdma_in_fault_count;
            AHB_DMA.in_intr[s_rx_dma_ch].clr.val = raw;
            flags |= LAG_EVT_GDMA_IN_FAULT;
        }
    }
    if (s_tx_dma_ch >= 0 && s_tx_dma_ch < 3) {
        uint32_t raw = AHB_DMA.out_intr[s_tx_dma_ch].raw.val & GDMA_OUT_FAULT_MASK;
        if (raw) {
            ++s_hw_counters.gdma_out_fault_count;
            AHB_DMA.out_intr[s_tx_dma_ch].clr.val = raw;
            flags |= LAG_EVT_GDMA_OUT_FAULT;
        }
    }

    if (tx_rempty && BITSCRAMBLER.state[BITSCRAMBLER_DIR_TX].fifo_empty) {
        ++s_hw_counters.bs_fifo_empty_count;
    }
    if (BITSCRAMBLER.state[BITSCRAMBLER_DIR_TX].eof_overload) {
        ++s_hw_counters.bs_eof_overload_count;
        BITSCRAMBLER.state[BITSCRAMBLER_DIR_TX].val = 1u << 31;
        flags |= LAG_EVT_BS_EOF_OVERLOAD;
    }

    ++s_hw_counters.checks;
    record_transport_event(flags);
}

static hw_transport_counters_t lab_counter_snapshot(void)
{
    hw_transport_counters_t snapshot;
    memcpy(&snapshot, (const void *)&s_hw_counters, sizeof(snapshot));
    return snapshot;
}

static void lab_clear_transport_sticky(void)
{
    PARL_IO.int_clr.val = UINT32_MAX;
    if (s_rx_dma_ch >= 0) AHB_DMA.in_intr[s_rx_dma_ch].clr.val = UINT32_MAX;
    if (s_tx_dma_ch >= 0) AHB_DMA.out_intr[s_tx_dma_ch].clr.val = UINT32_MAX;
    BITSCRAMBLER.state[BITSCRAMBLER_DIR_TX].val = 1u << 31;
}

static void lab_reset_correlation(void)
{
    memset((void *)&s_hw_counters, 0, sizeof(s_hw_counters));
    memset(s_lag_events, 0, sizeof(s_lag_events));
    s_lag_event_head = 0;
    s_last_transport_event_us = 0;
    s_last_transport_flags = 0;
    s_last_user_lag_mark_us = 0;
    s_last_gain_write_us = 0;
    s_last_phy_write_us = 0;
    s_last_phy_write_kind = PHY_WRITE_NONE;
    s_last_gain_drop_transition = s_gain_transition_count;
    lab_clear_transport_sticky();
}

static uint32_t lab_delta(uint32_t current, uint32_t base)
{
    return current - base;
}

static void lab_print_row(const char *kind, const hw_transport_counters_t *base)
{
    const hw_transport_counters_t current = lab_counter_snapshot();
    const hw_transport_counters_t zero = {0};
    if (!base) base = &zero;

    int64_t now = esp_timer_get_time();
    long long gain_age_ms = s_last_gain_write_us > 0 ?
        (long long)((now - s_last_gain_write_us) / 1000) : -1;
    long long transport_age_ms = s_last_transport_event_us > 0 ?
        (long long)((now - s_last_transport_event_us) / 1000) : -1;
    long long phy_age_ms = s_last_phy_write_us > 0 ?
        (long long)((now - s_last_phy_write_us) / 1000) : -1;

    rf_phy_snapshot_t phy = {0};
    rf_get_phy_snapshot(&phy);

    printf("C5VRX_LAB_ROW kind=%s gain=%u gain_reg=0x%08lx bw=%u afc=%u offset_khz=%d "
           "agc=%u state=%u profile=%u p=%d q=%d clip_pm=%d origin_pm=%d strength=%d "
           "nf_valid=%u nf_dbm=%d rssi_valid=%u rssi_dbm=%d "
           "dc_i_x100=%d dc_q_x100=%d iq_skew_pm=%d iq_cross_pm=%d "
           "winding_pm=%d strong_winding_pm=%d sync_q=%d sync_width=%u "
           "fusion_ctx=%d fusion_q=%d fusion_conf=%d fusion_lowiq_pm=%d "
           "fusion_lag2_pm=%d fusion_lag4_pm=%d fusion_consensus_pm=%d fusion_slope_x100=%d "
           "traj_uncert_pm=%d pll_slip_pm=%d pll_hold_pm=%d demod=%u "
           "fusion_risk=%d fusion_fade=%d fusion_recovery=%d fusion_stability=%d fusion_fast_n=%lu "
           "tx_quiet=%u fft_forced=%u fft=%d filter_mode=%u adc_sel=%u filter_reg=0x%08lx "
           "adc_reg=0x%08lx source_mux=0x%08lx rf_stage=%u rf_code=%u bb_code=%u fine=%u "
           "packed=0x%08lx iq_en=%u iq_c0=%d iq_c1=%d iq_reg=0x%08lx "
           "tx_empty=%lu rx_ovf=%lu tx_eof=%lu gdma_in=%lu gdma_out=%lu "
           "bs_empty=%lu bs_eof=%lu lag=%lu near_gain=%lu near_phy=%lu qdrop=%lu "
           "gain_age_ms=%lld phy_age_ms=%lld phy_kind=%u transport_age_ms=%lld last_flags=0x%02lx\n",
           kind, s_current_gain, (unsigned long)phy.gain_reg,
           s_current_bw40 ? 40u : 20u, (unsigned)s_afc_mode,
           rf_get_frequency_offset_khz(), (unsigned)s_agc_mode, (unsigned)s_agc_state,
           (unsigned)s_rx_profile,
           s_last_p_median, s_last_q_phase, s_last_clip_permille,
           s_last_origin_permille, s_signal_strength,
           s_noise_floor_valid ? 1u : 0u, s_last_noise_floor_dbm,
           s_phy_rssi_valid ? 1u : 0u, s_last_phy_rssi_dbm,
           s_last_dc_i_x100, s_last_dc_q_x100,
           s_last_iq_skew_permille, s_last_iq_cross_permille,
           s_last_winding_permille, s_last_strong_winding_permille,
           s_last_sync_quality, (unsigned)s_last_sync_width_20m,
           s_last_fusion_context, s_last_fusion_quality, s_last_fusion_confidence,
           s_last_fusion_low_confidence_pm, s_last_fusion_lag2_pm,
           s_last_fusion_lag4_pm, s_last_fusion_consensus_pm, s_last_fusion_slope_x100,
           s_last_trajectory_uncertainty_pm, s_last_pll_lite_slip_pm,
           s_last_pll_lite_hold_pm, (unsigned)s_demod_mode,
           s_last_fusion_risk, s_last_fusion_fade, s_last_fusion_recovery,
           s_last_fusion_stability, (unsigned long)s_last_fusion_fast_samples,
           s_lab_tx_quiet ? 1u : 0u,
           s_lab_fft_forced ? 1u : 0u, (int)s_lab_fft_value,
           (unsigned)phy.rx_filter_mode, (unsigned)phy.adc_rate_sel,
           (unsigned long)phy.rx_filter_reg, (unsigned long)phy.adc_rate_reg,
           (unsigned long)phy.source_mux_reg,
           (unsigned)phy.gain_tuple.rf_stage, (unsigned)phy.gain_tuple.rf_code,
           (unsigned)phy.gain_tuple.bb_code, (unsigned)phy.gain_tuple.fine_code,
           (unsigned long)phy.gain_tuple.packed_state,
           (unsigned)phy.iq_correction.enable, (int)phy.iq_correction.coef0,
           (int)phy.iq_correction.coef1,
           (unsigned long)phy.iq_correction_reg,
           (unsigned long)lab_delta(current.parl_tx_rempty_count, base->parl_tx_rempty_count),
           (unsigned long)lab_delta(current.parl_rx_wovf_count, base->parl_rx_wovf_count),
           (unsigned long)lab_delta(current.parl_tx_eof_count, base->parl_tx_eof_count),
           (unsigned long)lab_delta(current.gdma_in_fault_count, base->gdma_in_fault_count),
           (unsigned long)lab_delta(current.gdma_out_fault_count, base->gdma_out_fault_count),
           (unsigned long)lab_delta(current.bs_fifo_empty_count, base->bs_fifo_empty_count),
           (unsigned long)lab_delta(current.bs_eof_overload_count, base->bs_eof_overload_count),
           (unsigned long)lab_delta(current.lag_event_count, base->lag_event_count),
           (unsigned long)lab_delta(current.near_gain_event_count, base->near_gain_event_count),
           (unsigned long)lab_delta(current.near_phy_event_count, base->near_phy_event_count),
           (unsigned long)lab_delta(current.gain_quality_drop_count, base->gain_quality_drop_count),
           gain_age_ms, phy_age_ms, (unsigned)s_last_phy_write_kind,
           transport_age_ms, (unsigned long)s_last_transport_flags);
}

static void lab_apply_fixed_gain(uint8_t gain)
{
    if (gain < LAB_GAIN_MIN) gain = LAB_GAIN_MIN;
    if (gain > LAB_GAIN_MAX) gain = LAB_GAIN_MAX;
    s_current_gain = gain;
    s_shadow_gain = gain;
    s_last_gain_write_us = esp_timer_get_time();
    s_last_phy_write_us = s_last_gain_write_us;
    s_last_phy_write_kind = PHY_WRITE_GAIN;
    rf_set_rx_gain(true, gain);
    ++s_gain_transition_count;
}

/* PRE-Q4 characterization may intentionally explore the complete vendor-
 * generated table above legacy G62. This bypasses profile clamps but never
 * writes a hand-built PBUS tuple: phy_force_rx_gain() still owns the state. */
static void lab_apply_vendor_gain(uint8_t gain)
{
    const arc_gain_table_t *table = rf_get_arc_gain_table();
    if (gain < 2u) gain = 2u;
    if (gain > table->max_index) gain = table->max_index;
    s_current_gain = gain;
    s_shadow_gain = gain;
    s_last_gain_write_us = esp_timer_get_time();
    s_last_phy_write_us = s_last_gain_write_us;
    s_last_phy_write_kind = PHY_WRITE_GAIN;
    rf_set_rx_gain(true, gain);
    ++s_gain_transition_count;
}

static void lab_finish_gain_sweep(bool aborted)
{
    if (!s_gain_sweep.active) return;

    const uint8_t saved_gain = s_gain_sweep.saved_gain;
    const uint8_t saved_shadow_gain = s_gain_sweep.saved_shadow_gain;
    const analog_agc_mode_t saved_agc_mode = s_gain_sweep.saved_agc_mode;
    const agc_state_t saved_agc_state = s_gain_sweep.saved_agc_state;
    const rf_bw_mode_t saved_bw_mode = s_gain_sweep.saved_bw_mode;
    const bool saved_bw40 = s_gain_sweep.saved_bw40;
    const afc_mode_t saved_afc_mode = s_gain_sweep.saved_afc_mode;
    const int saved_offset_khz = s_gain_sweep.saved_offset_khz;
    const bool saved_quiet = s_gain_sweep.saved_quiet;

    s_gain_sweep.active = false;

    /* Keep MANUAL long enough for analog_agc_task's private target_gain to
     * follow the restored physical gain before restoring ACTIVE/SHADOW. */
    s_agc_mode = ANALOG_AGC_MANUAL;
    if (s_current_gain != saved_gain) lab_apply_fixed_gain(saved_gain);
    s_shadow_gain = saved_gain;
    vTaskDelay(pdMS_TO_TICKS(120));

    s_rf_bw_mode = saved_bw_mode;
    if (s_current_bw40 != saved_bw40) apply_rf_bandwidth(saved_bw40);
    s_afc_mode = saved_afc_mode;
    apply_frequency_offset_khz_tracked(saved_offset_khz);
    s_agc_state = saved_agc_state;
    s_shadow_gain = saved_shadow_gain;
    s_agc_mode = saved_agc_mode;
    s_lab_quiet = saved_quiet;

    printf("C5VRX_GAIN_SWEEP_END status=%s restored_gain=%u restored_agc=%u restored_bw=%u\n",
           aborted ? "ABORTED" : "COMPLETE", saved_gain, (unsigned)saved_agc_mode,
           saved_bw40 ? 40u : 20u);
}

static void lab_start_gain_sweep(void)
{
    if (s_gain_sweep.active) {
        lab_finish_gain_sweep(true);
        return;
    }
    if (s_menu_active) {
        printf("C5VRX_GAIN_SWEEP_REFUSED reason=menu_active\n");
        return;
    }

    s_gain_sweep = (lab_gain_sweep_t) {
        .active = true,
        .sampled = false,
        .gain = LAB_GAIN_MIN,
        .saved_gain = s_current_gain,
        .saved_shadow_gain = s_shadow_gain,
        .saved_agc_mode = s_agc_mode,
        .saved_agc_state = s_agc_state,
        .saved_bw_mode = s_rf_bw_mode,
        .saved_bw40 = s_current_bw40,
        .saved_afc_mode = s_afc_mode,
        .saved_offset_khz = rf_get_frequency_offset_khz(),
        .saved_quiet = s_lab_quiet,
    };

    s_agc_mode = ANALOG_AGC_MANUAL;
    s_rf_bw_mode = RF_BW_MODE_BW40;
    if (!s_current_bw40) apply_rf_bandwidth(true);
    s_afc_mode = AFC_MODE_OFF;
    if (rf_get_frequency_offset_khz() != 0) apply_frequency_offset_khz_tracked(0);
    s_lab_quiet = true;

    /* Let a possible BW/AFC transition finish before the first measured gain
     * state. No sample traffic is CPU-paced during this delay. */
    vTaskDelay(pdMS_TO_TICKS(300));
    lab_reset_correlation();

    printf("C5VRX_GAIN_SWEEP_BEGIN min=%u max=%u step=%u settle_ms=%u dwell_ms=%u "
           "bw=40 afc=off output=%s\n",
           LAB_GAIN_MIN, LAB_GAIN_MAX, LAB_GAIN_STEP,
           LAB_GAIN_SETTLE_MS, LAB_GAIN_DWELL_MS, output_mode_name());

    s_gain_sweep.step_base = lab_counter_snapshot();
    lab_apply_fixed_gain(s_gain_sweep.gain);
    s_gain_sweep.applied_us = esp_timer_get_time();
}

static void lab_gain_sweep_tick(void)
{
    if (!s_gain_sweep.active) return;

    int64_t elapsed_us = esp_timer_get_time() - s_gain_sweep.applied_us;
    if (!s_gain_sweep.sampled &&
        elapsed_us >= (int64_t)LAB_GAIN_SETTLE_MS * 1000LL) {
        lab_print_row("GAIN_SWEEP", &s_gain_sweep.step_base);
        s_gain_sweep.sampled = true;
    }

    if (elapsed_us < (int64_t)LAB_GAIN_DWELL_MS * 1000LL) return;

    if (s_gain_sweep.gain + LAB_GAIN_STEP <= LAB_GAIN_MAX) {
        s_gain_sweep.gain = (uint8_t)(s_gain_sweep.gain + LAB_GAIN_STEP);
        s_gain_sweep.step_base = lab_counter_snapshot();
        s_gain_sweep.sampled = false;
        lab_apply_fixed_gain(s_gain_sweep.gain);
        s_gain_sweep.applied_us = esp_timer_get_time();
    } else {
        lab_finish_gain_sweep(false);
    }
}

static void lab_enter_quiet_baseline(void)
{
    if (s_gain_sweep.active) {
        printf("C5VRX_LAB_BASELINE_REFUSED reason=gain_sweep_active\n");
        return;
    }
    if (s_menu_active) {
        printf("C5VRX_LAB_BASELINE_REFUSED reason=menu_active\n");
        return;
    }

    s_agc_mode = ANALOG_AGC_MANUAL;
    s_rf_bw_mode = RF_BW_MODE_BW40;
    if (!s_current_bw40) apply_rf_bandwidth(true);
    s_afc_mode = AFC_MODE_OFF;
    if (rf_get_frequency_offset_khz() != 0) apply_frequency_offset_khz_tracked(0);
    s_lab_quiet = true;

    /* Baseline starts only after control-path setup transients are outside the
     * run. Then all counters/timestamps are cleared in one explicit action. */
    vTaskDelay(pdMS_TO_TICKS(600));
    lab_reset_correlation();

    printf("C5VRX_LAB_BASELINE_READY gain=%u bw=40 afc=off quiet=1 "
           "instruction=do_not_touch_console_until_event\n", s_current_gain);
}


/* Deterministic FFT A/B. Espressif exposes FFT gain separately from AGC gain;
 * this probe answers the only question that matters to C5VRX: does forcing it
 * change the raw MODEM_DIAG Q4/I4 statistics? Production never forces FFT. */
static void lab_run_fft_probe(void)
{
    if (s_gain_sweep.active || s_menu_active) {
        printf("C5VRX_FFT_PROBE_REFUSED reason=%s\n",
               s_gain_sweep.active ? "gain_sweep_active" : "menu_active");
        return;
    }

    const analog_agc_mode_t saved_agc_mode = s_agc_mode;
    const agc_state_t saved_agc_state = s_agc_state;
    const rf_bw_mode_t saved_bw_mode = s_rf_bw_mode;
    const bool saved_bw40 = s_current_bw40;
    const afc_mode_t saved_afc_mode = s_afc_mode;
    const int saved_offset = rf_get_frequency_offset_khz();
    const bool saved_quiet = s_lab_quiet;
    const uint8_t saved_gain = s_current_gain;
    const uint8_t saved_shadow = s_shadow_gain;

    s_agc_mode = ANALOG_AGC_MANUAL;
    s_rf_bw_mode = RF_BW_MODE_BW40;
    if (!s_current_bw40) apply_rf_bandwidth(true);
    s_afc_mode = AFC_MODE_OFF;
    if (saved_offset != 0) apply_frequency_offset_khz_tracked(0);
    s_lab_quiet = true;
    vTaskDelay(pdMS_TO_TICKS(300));
    lab_reset_correlation();

    /* Establish an automatic-scaling baseline before the forced values. */
    rf_set_fft_scale_force(false, 0);
    s_lab_fft_forced = false;
    s_lab_fft_value = 0;
    s_profile_fft_forced = false;
    vTaskDelay(pdMS_TO_TICKS(250));
    int baseline_score = s_last_q_phase * 4 + s_last_p_median
                       - s_last_clip_permille / 5
                       - s_last_origin_permille / 20
                       - s_last_iq_skew_permille / 25
                       - s_last_iq_cross_permille / 25;
    int best_score = baseline_score;
    int8_t best_value = 0;
    lab_print_row("FFT_BASELINE", NULL);

    printf("C5VRX_FFT_PROBE_BEGIN gain=%u bw=40 values=16,24,32,40 settle_ms=%u baseline=%d\n",
           s_current_gain, LAB_FFT_SETTLE_MS, baseline_score);

    for (unsigned i = 0; i < sizeof(s_lab_fft_values) / sizeof(s_lab_fft_values[0]); ++i) {
        const hw_transport_counters_t base = lab_counter_snapshot();
        s_lab_fft_value = s_lab_fft_values[i];
        s_lab_fft_forced = true;
        s_last_phy_write_us = esp_timer_get_time();
        s_last_phy_write_kind = PHY_WRITE_FFT;
        rf_set_fft_scale_force(true, s_lab_fft_value);
        vTaskDelay(pdMS_TO_TICKS(LAB_FFT_SETTLE_MS));
        lab_print_row("FFT_SWEEP", &base);
        int score = s_last_q_phase * 4 + s_last_p_median
                  - s_last_clip_permille / 5
                  - s_last_origin_permille / 20
                  - s_last_iq_skew_permille / 25
                  - s_last_iq_cross_permille / 25;
        if (score > best_score) {
            best_score = score;
            best_value = s_lab_fft_value;
        }
        if (LAB_FFT_DWELL_MS > LAB_FFT_SETTLE_MS) {
            vTaskDelay(pdMS_TO_TICKS(LAB_FFT_DWELL_MS - LAB_FFT_SETTLE_MS));
        }
    }

    s_last_phy_write_us = esp_timer_get_time();
    s_last_phy_write_kind = PHY_WRITE_FFT;
    rf_set_fft_scale_force(false, 0);
    s_lab_fft_forced = false;
    s_lab_fft_value = 0;
    s_fft_q4_effect_known = true;
    /* Require a clear improvement so AUTO never promotes FFT gain because of
     * ordinary 50 ms control-window jitter. */
    s_fft_q4_effective = best_value != 0 && best_score >= baseline_score + 12;
    s_fft_best_value = s_fft_q4_effective ? best_value : 0;
    vTaskDelay(pdMS_TO_TICKS(120));

    s_rf_bw_mode = saved_bw_mode;
    if (s_current_bw40 != saved_bw40) apply_rf_bandwidth(saved_bw40);
    s_afc_mode = saved_afc_mode;
    if (rf_get_frequency_offset_khz() != saved_offset) {
        apply_frequency_offset_khz_tracked(saved_offset);
    }
    if (s_current_gain != saved_gain) lab_apply_fixed_gain(saved_gain);
    s_shadow_gain = saved_shadow;
    s_agc_state = saved_agc_state;
    s_agc_mode = saved_agc_mode;
    s_lab_quiet = saved_quiet;

    if (s_rx_profile == RX_PROFILE_AUTO_EXP && s_fft_q4_effective) {
        s_last_phy_write_us = esp_timer_get_time();
        s_last_phy_write_kind = PHY_WRITE_FFT;
        rf_set_fft_scale_force(true, s_fft_best_value);
        s_profile_fft_forced = true;
    }

    printf("C5VRX_FFT_PROBE_END restored_gain=%u restored_agc=%u restored_bw=%u "
           "q4_effect=%s best_fft=%d delta=%d\n",
           saved_gain, (unsigned)saved_agc_mode, saved_bw40 ? 40u : 20u,
           s_fft_q4_effective ? "YES" : "NO", (int)s_fft_best_value,
           best_score - baseline_score);
}

/* Safe first filter experiment: only exercise the already-used
 * phy_wifi_fbw_sel() BW40/BW20 path. Unknown channel-filter ROM calls remain
 * read-only research candidates until their C5 ABI and register effects are
 * proven. */
static void lab_run_bandwidth_probe(void)
{
    if (s_gain_sweep.active || s_menu_active) {
        printf("C5VRX_BW_PROBE_REFUSED reason=%s\n",
               s_gain_sweep.active ? "gain_sweep_active" : "menu_active");
        return;
    }

    const analog_agc_mode_t saved_agc_mode = s_agc_mode;
    const agc_state_t saved_agc_state = s_agc_state;
    const rf_bw_mode_t saved_bw_mode = s_rf_bw_mode;
    const bool saved_bw40 = s_current_bw40;
    const afc_mode_t saved_afc_mode = s_afc_mode;
    const int saved_offset = rf_get_frequency_offset_khz();
    const bool saved_quiet = s_lab_quiet;
    const bool saved_profile_fft = s_profile_fft_forced;
    const int8_t saved_profile_fft_value = s_fft_best_value;

    s_agc_mode = ANALOG_AGC_MANUAL;
    s_afc_mode = AFC_MODE_OFF;
    if (saved_offset != 0) apply_frequency_offset_khz_tracked(0);
    s_lab_quiet = true;
    rf_set_fft_scale_force(false, 0);
    s_lab_fft_forced = false;
    s_lab_fft_value = 0;
    s_profile_fft_forced = false;
    vTaskDelay(pdMS_TO_TICKS(250));
    lab_reset_correlation();

    printf("C5VRX_BW_PROBE_BEGIN gain=%u settle_ms=%u order=40,20\n",
           s_current_gain, LAB_BW_SETTLE_MS);

    const bool states[2] = {true, false};
    for (unsigned i = 0; i < 2; ++i) {
        const hw_transport_counters_t base = lab_counter_snapshot();
        apply_rf_bandwidth(states[i]);
        vTaskDelay(pdMS_TO_TICKS(LAB_BW_SETTLE_MS));
        lab_print_row("BW_SWEEP", &base);
    }

    s_rf_bw_mode = saved_bw_mode;
    if (s_current_bw40 != saved_bw40) apply_rf_bandwidth(saved_bw40);
    s_afc_mode = saved_afc_mode;
    if (rf_get_frequency_offset_khz() != saved_offset) {
        apply_frequency_offset_khz_tracked(saved_offset);
    }
    s_agc_state = saved_agc_state;
    s_agc_mode = saved_agc_mode;
    s_lab_quiet = saved_quiet;
    if (saved_profile_fft && saved_profile_fft_value != 0) {
        s_last_phy_write_us = esp_timer_get_time();
        s_last_phy_write_kind = PHY_WRITE_FFT;
        rf_set_fft_scale_force(true, saved_profile_fft_value);
        s_profile_fft_forced = true;
    }

    printf("C5VRX_BW_PROBE_END restored_agc=%u restored_bw=%u\n",
           (unsigned)saved_agc_mode, saved_bw40 ? 40u : 20u);
}


/* PRE-Q4 far-state characterization. ARC has statically recovered the vendor
 * RF-stage boundary, but G61+ still needs physical proof: indices above the
 * highest RF-stage entry can add downstream BB/fine gain without adding RF
 * sensitivity. Sweep only valid generated indices and score raw Q4/video. */
static void lab_run_far_gain_probe(void)
{
    if (s_gain_sweep.active || s_menu_active || s_pre_q4_probe_active) {
        printf("C5VRX_PREQ4_FAR_REFUSED reason=%s\n",
               s_gain_sweep.active ? "gain_sweep_active" :
               s_menu_active ? "menu_active" : "preq4_busy");
        return;
    }

    const arc_gain_table_t *table = rf_get_arc_gain_table();
    const uint8_t first = rf_get_arc_survival_gain();
    const uint8_t last = table->max_index;
    if (first > last) {
        printf("C5VRX_PREQ4_FAR_REFUSED reason=invalid_vendor_table first=%u max=%u\n",
               first, last);
        return;
    }

    const uint8_t saved_gain = s_current_gain;
    const uint8_t saved_shadow = s_shadow_gain;
    const analog_agc_mode_t saved_agc_mode = s_agc_mode;
    const agc_state_t saved_agc_state = s_agc_state;
    const rf_bw_mode_t saved_bw_mode = s_rf_bw_mode;
    const bool saved_bw40 = s_current_bw40;
    const afc_mode_t saved_afc_mode = s_afc_mode;
    const int saved_offset = rf_get_frequency_offset_khz();
    const bool saved_quiet = s_lab_quiet;
    const bool saved_profile_fft = s_profile_fft_forced;
    const int8_t saved_profile_fft_value = s_fft_best_value;

    s_pre_q4_probe_active = true;
    s_agc_mode = ANALOG_AGC_MANUAL;
    s_rf_bw_mode = RF_BW_MODE_BW40;
    if (!s_current_bw40) apply_rf_bandwidth(true);
    s_afc_mode = AFC_MODE_OFF;
    if (saved_offset != 0) apply_frequency_offset_khz_tracked(0);
    s_lab_quiet = true;
    if (s_profile_fft_forced) {
        s_last_phy_write_us = esp_timer_get_time();
        s_last_phy_write_kind = PHY_WRITE_FFT;
        rf_set_fft_scale_force(false, 0);
        s_profile_fft_forced = false;
    }

    vTaskDelay(pdMS_TO_TICKS(300));
    lab_reset_correlation();
    printf("C5VRX_PREQ4_FAR_BEGIN first=%u max=%u step=1 settle_ms=%u bw=40 afc=off\n",
           first, last, LAB_GAIN_SETTLE_MS);

    for (unsigned gain = first; gain <= last; ++gain) {
        const hw_transport_counters_t base = lab_counter_snapshot();
        lab_apply_vendor_gain((uint8_t)gain);
        vTaskDelay(pdMS_TO_TICKS(LAB_GAIN_SETTLE_MS));
        lab_print_row("PREQ4_FAR_GAIN", &base);
    }

    lab_apply_vendor_gain(saved_gain);
    vTaskDelay(pdMS_TO_TICKS(120));
    s_shadow_gain = saved_shadow;
    s_rf_bw_mode = saved_bw_mode;
    if (s_current_bw40 != saved_bw40) apply_rf_bandwidth(saved_bw40);
    s_afc_mode = saved_afc_mode;
    if (rf_get_frequency_offset_khz() != saved_offset)
        apply_frequency_offset_khz_tracked(saved_offset);
    s_agc_state = saved_agc_state;
    s_agc_mode = saved_agc_mode;
    s_lab_quiet = saved_quiet;
    if (saved_profile_fft && saved_profile_fft_value != 0) {
        s_last_phy_write_us = esp_timer_get_time();
        s_last_phy_write_kind = PHY_WRITE_FFT;
        rf_set_fft_scale_force(true, saved_profile_fft_value);
        s_profile_fft_forced = true;
    }
    s_pre_q4_probe_active = false;

    printf("C5VRX_PREQ4_FAR_END restored_gain=%u restored_agc=%u restored_bw=%u\n",
           saved_gain, (unsigned)saved_agc_mode, saved_bw40 ? 40u : 20u);
}

/* Request a fresh vendor PHY calibration on the next boot. The live receiver
 * is never recalibrated in place: only the stored PHY calibration namespace is
 * erased, then C5VRX reboots immediately. */
static void lab_request_fresh_phy_calibration(void)
{
    if (s_gain_sweep.active || s_menu_active || s_pre_q4_probe_active) {
        printf("C5VRX_PREQ4_FULLCAL_REFUSED reason=%s\n",
               s_gain_sweep.active ? "gain_sweep_active" :
               s_menu_active ? "menu_active" : "preq4_busy");
        return;
    }

    esp_err_t err = rf_prepare_fresh_phy_calibration();
    if (err != ESP_OK) {
        printf("C5VRX_PREQ4_FULLCAL_ERROR err=%s\n", esp_err_to_name(err));
        return;
    }

    printf("C5VRX_PREQ4_FULLCAL_ARMED action=reboot next_boot=fresh_vendor_phy_calibration\n");
    fflush(stdout);
    vTaskDelay(pdMS_TO_TICKS(120));
    esp_restart();
}

/* Acquisition-only centering characterization. This deliberately does not
 * become a continuous AFC loop: each PHY retune can disturb analog video.
 * The probe scores actual demod/sync quality and restores the prior offset. */
static void lab_run_frequency_probe(void)
{
    if (s_gain_sweep.active || s_menu_active) {
        printf("C5VRX_AFC_PROBE_REFUSED reason=%s\n",
               s_gain_sweep.active ? "gain_sweep_active" : "menu_active");
        return;
    }

    const analog_agc_mode_t saved_agc_mode = s_agc_mode;
    const agc_state_t saved_agc_state = s_agc_state;
    const rf_bw_mode_t saved_bw_mode = s_rf_bw_mode;
    const bool saved_bw40 = s_current_bw40;
    const afc_mode_t saved_afc_mode = s_afc_mode;
    const int saved_offset = rf_get_frequency_offset_khz();
    const bool saved_quiet = s_lab_quiet;

    s_agc_mode = ANALOG_AGC_MANUAL;
    s_rf_bw_mode = RF_BW_MODE_BW40;
    if (!s_current_bw40) apply_rf_bandwidth(true);
    s_afc_mode = AFC_MODE_HOLD;
    s_lab_quiet = true;
    vTaskDelay(pdMS_TO_TICKS(250));
    lab_reset_correlation();

    static const int offsets[] = {
        -1000, -750, -500, -250, 0, 250, 500, 750, 1000
    };
    int best_offset = saved_offset;
    int best_score = -100000;

    printf("C5VRX_AFC_PROBE_BEGIN gain=%u bw=40 settle_ms=650 offsets=-1000..1000\n",
           s_current_gain);

    for (unsigned i = 0; i < sizeof(offsets) / sizeof(offsets[0]); ++i) {
        const hw_transport_counters_t base = lab_counter_snapshot();
        apply_frequency_offset_khz_tracked(offsets[i]);
        vTaskDelay(pdMS_TO_TICKS(650));
        lab_print_row("AFC_SWEEP", &base);

        int score = s_last_fusion_quality +
                    s_last_sync_quality * 3 -
                    s_last_fusion_risk / 2 -
                    s_last_winding_permille / 2;
        if (score > best_score) {
            best_score = score;
            best_offset = offsets[i];
        }
    }

    apply_frequency_offset_khz_tracked(saved_offset);
    s_rf_bw_mode = saved_bw_mode;
    if (s_current_bw40 != saved_bw40) apply_rf_bandwidth(saved_bw40);
    s_afc_mode = saved_afc_mode;
    s_agc_state = saved_agc_state;
    s_agc_mode = saved_agc_mode;
    s_lab_quiet = saved_quiet;

    printf("C5VRX_AFC_PROBE_END best_offset_khz=%d best_score=%d restored_offset_khz=%d\n",
           best_offset, best_score, saved_offset);
}


typedef struct {
    uint8_t gain;
    bool bw40;
    int offset_khz;
    rx_auto_observation_t obs;
    bool valid;
    bool ref_stable;
} rx_auto_candidate_t;

typedef struct {
    uint8_t gain;
    uint8_t shadow_gain;
    analog_agc_mode_t agc_mode;
    agc_state_t agc_state;
    rf_bw_mode_t bw_mode;
    bool bw40;
    afc_mode_t afc_mode;
    int offset_khz;
    bool quiet;
    bool profile_fft;
    int8_t profile_fft_value;
} rx_auto_saved_state_t;

static int rx_auto_median_int(int *v, unsigned n)
{
    for (unsigned i = 1; i < n; ++i) {
        int x = v[i];
        unsigned j = i;
        while (j > 0 && v[j - 1] > x) {
            v[j] = v[j - 1];
            --j;
        }
        v[j] = x;
    }
    return v[n / 2u];
}

static uint32_t rx_auto_transport_delta(const hw_transport_counters_t *base,
                                        const hw_transport_counters_t *now)
{
    return lab_delta(now->parl_rx_wovf_count, base->parl_rx_wovf_count) +
           lab_delta(now->parl_tx_rempty_count, base->parl_tx_rempty_count) +
           lab_delta(now->parl_tx_eof_count, base->parl_tx_eof_count) +
           lab_delta(now->gdma_in_fault_count, base->gdma_in_fault_count) +
           lab_delta(now->gdma_out_fault_count, base->gdma_out_fault_count) +
           lab_delta(now->bs_fifo_empty_count, base->bs_fifo_empty_count) +
           lab_delta(now->bs_eof_overload_count, base->bs_eof_overload_count);
}

static rx_auto_observation_t rx_auto_collect_observation(
    const hw_transport_counters_t *fault_base)
{
    int p[RX_AUTO_SAMPLE_COUNT];
    int q[RX_AUTO_SAMPLE_COUNT];
    int clip[RX_AUTO_SAMPLE_COUNT];
    int origin[RX_AUTO_SAMPLE_COUNT];
    int skew[RX_AUTO_SAMPLE_COUNT];
    int cross[RX_AUTO_SAMPLE_COUNT];
    int winding[RX_AUTO_SAMPLE_COUNT];
    int sync[RX_AUTO_SAMPLE_COUNT];
    hw_transport_counters_t local_base = lab_counter_snapshot();
    if (!fault_base) fault_base = &local_base;

    for (unsigned i = 0; i < RX_AUTO_SAMPLE_COUNT; ++i) {
        vTaskDelay(pdMS_TO_TICKS(RX_AUTO_SAMPLE_SPACING_MS));
        p[i] = s_last_p_median;
        q[i] = s_last_q_phase;
        clip[i] = s_last_clip_permille;
        origin[i] = s_last_origin_permille;
        skew[i] = s_last_iq_skew_permille;
        cross[i] = s_last_iq_cross_permille;
        winding[i] = s_last_winding_permille;
        sync[i] = s_last_sync_quality;
    }

    hw_transport_counters_t now = lab_counter_snapshot();
    return (rx_auto_observation_t) {
        .p_median = rx_auto_median_int(p, RX_AUTO_SAMPLE_COUNT),
        .q_phase = rx_auto_median_int(q, RX_AUTO_SAMPLE_COUNT),
        .clip_permille = rx_auto_median_int(clip, RX_AUTO_SAMPLE_COUNT),
        .origin_permille = rx_auto_median_int(origin, RX_AUTO_SAMPLE_COUNT),
        .iq_skew_permille = rx_auto_median_int(skew, RX_AUTO_SAMPLE_COUNT),
        .iq_cross_permille = rx_auto_median_int(cross, RX_AUTO_SAMPLE_COUNT),
        .winding_permille = rx_auto_median_int(winding, RX_AUTO_SAMPLE_COUNT),
        .sync_quality = rx_auto_median_int(sync, RX_AUTO_SAMPLE_COUNT),
        .transport_faults = rx_auto_transport_delta(fault_base, &now),
    };
}

static void rx_auto_print_observation(const char *stage,
                                      const rx_auto_candidate_t *candidate)
{
    printf("C5VRX_RX_AUTO_OBS stage=%s gain=%u bw=%u offset_khz=%d "
           "class=%s ref_stable=%u p=%d q=%d clip_pm=%d origin_pm=%d "
           "iq_skew_pm=%d iq_cross_pm=%d winding_pm=%d sync_q=%d faults=%lu\n",
           stage, candidate->gain, candidate->bw40 ? 40u : 20u,
           candidate->offset_khz,
           rx_auto_class_name(rx_auto_classify(&candidate->obs)),
           candidate->ref_stable ? 1u : 0u,
           candidate->obs.p_median, candidate->obs.q_phase,
           candidate->obs.clip_permille, candidate->obs.origin_permille,
           candidate->obs.iq_skew_permille, candidate->obs.iq_cross_permille,
           candidate->obs.winding_permille, candidate->obs.sync_quality,
           (unsigned long)candidate->obs.transport_faults);
}

static void rx_auto_apply_config(uint8_t gain, bool bw40, int offset_khz,
                                 unsigned settle_ms)
{
    if (s_current_bw40 != bw40) apply_rf_bandwidth(bw40);
    if (rf_get_frequency_offset_khz() != offset_khz)
        apply_frequency_offset_khz_tracked(offset_khz);
    if (s_current_gain != gain) lab_apply_vendor_gain(gain);
    vTaskDelay(pdMS_TO_TICKS(settle_ms));
}

static void rx_auto_insert_top(rx_auto_candidate_t top[RX_AUTO_TOP_COUNT],
                               const rx_auto_candidate_t *candidate)
{
    if (!candidate->valid || !candidate->ref_stable ||
        rx_auto_classify(&candidate->obs) == RX_AUTO_REJECT)
        return;

    for (unsigned i = 0; i < RX_AUTO_TOP_COUNT; ++i) {
        if (!top[i].valid || rx_auto_better(&candidate->obs, &top[i].obs)) {
            for (unsigned j = RX_AUTO_TOP_COUNT - 1u; j > i; --j)
                top[j] = top[j - 1u];
            top[i] = *candidate;
            top[i].valid = true;
            return;
        }
    }
}

static bool rx_auto_measure_against_reference(const char *stage,
                                              uint8_t gain, bool bw40,
                                              int offset_khz,
                                              unsigned settle_ms,
                                              uint8_t ref_gain,
                                              rx_auto_observation_t *ref_before,
                                              rx_auto_candidate_t *candidate)
{
    hw_transport_counters_t base = lab_counter_snapshot();
    rx_auto_apply_config(gain, bw40, offset_khz, settle_ms);
    candidate->gain = gain;
    candidate->bw40 = bw40;
    candidate->offset_khz = offset_khz;
    candidate->obs = rx_auto_collect_observation(&base);
    candidate->valid = true;
    lab_print_row(stage, &base);

    hw_transport_counters_t ref_base = lab_counter_snapshot();
    rx_auto_apply_config(ref_gain, true, 0, RX_AUTO_GAIN_SETTLE_MS);
    rx_auto_observation_t ref_after = rx_auto_collect_observation(&ref_base);
    candidate->ref_stable = rx_auto_reference_stable(ref_before, &ref_after);
    rx_auto_print_observation(stage, candidate);

    printf("C5VRX_RX_AUTO_REF stage=%s stable=%u before_p=%d before_q=%d "
           "before_origin=%d before_clip=%d after_p=%d after_q=%d "
           "after_origin=%d after_clip=%d\n",
           stage, candidate->ref_stable ? 1u : 0u,
           ref_before->p_median, ref_before->q_phase,
           ref_before->origin_permille, ref_before->clip_permille,
           ref_after.p_median, ref_after.q_phase,
           ref_after.origin_permille, ref_after.clip_permille);
    *ref_before = ref_after;
    return candidate->ref_stable;
}

static void rx_auto_restore_saved(const rx_auto_saved_state_t *saved)
{
    if (s_current_bw40 != saved->bw40) apply_rf_bandwidth(saved->bw40);
    if (rf_get_frequency_offset_khz() != saved->offset_khz)
        apply_frequency_offset_khz_tracked(saved->offset_khz);
    if (s_current_gain != saved->gain) lab_apply_vendor_gain(saved->gain);

    s_shadow_gain = saved->shadow_gain;
    s_rf_bw_mode = saved->bw_mode;
    s_afc_mode = saved->afc_mode;
    s_agc_state = saved->agc_state;
    s_agc_mode = saved->agc_mode;
    s_lab_quiet = saved->quiet;

    if (saved->profile_fft && saved->profile_fft_value != 0) {
        s_last_phy_write_us = esp_timer_get_time();
        s_last_phy_write_kind = PHY_WRITE_FFT;
        rf_set_fft_scale_force(true, saved->profile_fft_value);
        s_profile_fft_forced = true;
    }
}

static void rx_auto_freeze_winner(const rx_auto_candidate_t *winner,
                                  bool saved_quiet)
{
    rx_auto_apply_config(winner->gain, winner->bw40, winner->offset_khz, 200u);
    s_shadow_gain = winner->gain;
    s_agc_mode = ANALOG_AGC_MANUAL;
    s_agc_state = AGC_STATE_TRACK;
    s_rf_bw_mode = winner->bw40 ? RF_BW_MODE_BW40 : RF_BW_MODE_BW20;
    s_afc_mode = AFC_MODE_HOLD;
    s_lab_quiet = saved_quiet;
}

static void rx_auto_refine_overload(uint8_t ref_gain,
                                    rx_auto_observation_t *ref_before,
                                    rx_auto_candidate_t top[RX_AUTO_TOP_COUNT],
                                    unsigned *stable_count)
{
    if (!top[0].valid) return;
    int center = top[0].gain;
    int lo = center - 3;
    int hi = center + 3;
    if (lo < 2) lo = 2;
    if (hi > ref_gain) hi = ref_gain;

    for (int gain = lo; gain <= hi; ++gain) {
        rx_auto_candidate_t candidate = {0};
        if (rx_auto_measure_against_reference("RX_AUTO_GAIN_REFINE",
                                              (uint8_t)gain, true, 0,
                                              RX_AUTO_GAIN_SETTLE_MS,
                                              ref_gain, ref_before,
                                              &candidate)) {
            ++*stable_count;
            rx_auto_insert_top(top, &candidate);
        }
    }
}

/* ARC V3 / RX AUTO LAB
 *
 * This is deliberately an opt-in characterization engine, not production ARC.
 * It separates Q4 placement from true RF sensitivity:
 *   1) repeated reference-guarded gain candidate search;
 *   2) BW40/BW20 only on the best gain candidates;
 *   3) carrier centering only on the best gain+BW tuple;
 *   4) alternating baseline/winner proof;
 *   5) ACQUIRED / OVERLOAD / RF_LIMIT / UNSTABLE classification.
 *
 * Clean live reception remains untouched until the user explicitly invokes U.
 */
static void lab_run_rx_auto(void)
{
    if (s_gain_sweep.active || s_menu_active || s_pre_q4_probe_active) {
        printf("C5VRX_RX_AUTO_REFUSED reason=%s\n",
               s_gain_sweep.active ? "gain_sweep_active" :
               s_menu_active ? "menu_active" : "preq4_busy");
        return;
    }

    const arc_gain_table_t *table = rf_get_arc_gain_table();
    const uint8_t ref_gain = rf_get_arc_survival_gain();
    if (ref_gain > table->max_index) {
        printf("C5VRX_RX_AUTO_REFUSED reason=invalid_vendor_table first=%u max=%u\n",
               ref_gain, table->max_index);
        return;
    }

    const rx_auto_saved_state_t saved = {
        .gain = s_current_gain,
        .shadow_gain = s_shadow_gain,
        .agc_mode = s_agc_mode,
        .agc_state = s_agc_state,
        .bw_mode = s_rf_bw_mode,
        .bw40 = s_current_bw40,
        .afc_mode = s_afc_mode,
        .offset_khz = rf_get_frequency_offset_khz(),
        .quiet = s_lab_quiet,
        .profile_fft = s_profile_fft_forced,
        .profile_fft_value = s_fft_best_value,
    };

    s_pre_q4_probe_active = true;
    s_agc_mode = ANALOG_AGC_MANUAL;
    s_agc_state = AGC_STATE_LEARN;
    s_rf_bw_mode = RF_BW_MODE_BW40;
    s_afc_mode = AFC_MODE_HOLD;
    s_lab_quiet = true;

    if (s_profile_fft_forced) {
        s_last_phy_write_us = esp_timer_get_time();
        s_last_phy_write_kind = PHY_WRITE_FFT;
        rf_set_fft_scale_force(false, 0);
        s_profile_fft_forced = false;
    }

    lab_reset_correlation();
    rx_auto_apply_config(ref_gain, true, 0, RX_AUTO_GAIN_SETTLE_MS);
    rx_auto_observation_t ref_before = rx_auto_collect_observation(NULL);

    const bool overload_mode = rx_auto_is_overload(&ref_before);
    printf("C5VRX_RX_AUTO_BEGIN first=%u max=%u baseline_class=%s "
           "mode=%s samples=%u proof_rounds=%u demod=%u\n",
           ref_gain, table->max_index,
           rx_auto_class_name(rx_auto_classify(&ref_before)),
           overload_mode ? "OVERLOAD_DESCENT" : "HIGH_STAGE",
           RX_AUTO_SAMPLE_COUNT, RX_AUTO_PROOF_ROUNDS,
           (unsigned)s_demod_mode);

    rx_auto_candidate_t top_gain[RX_AUTO_TOP_COUNT] = {0};
    unsigned stable_gain_count = 0;
    unsigned unstable_gain_count = 0;
    unsigned rf_limit_votes = 0;

    if (overload_mode) {
        for (int gain = ref_gain; gain >= 2; gain -= 4) {
            rx_auto_candidate_t candidate = {0};
            bool stable = rx_auto_measure_against_reference(
                "RX_AUTO_GAIN", (uint8_t)gain, true, 0,
                RX_AUTO_GAIN_SETTLE_MS, ref_gain, &ref_before, &candidate);
            if (stable) {
                ++stable_gain_count;
                if (rx_auto_is_rf_limit(&candidate.obs)) ++rf_limit_votes;
                rx_auto_insert_top(top_gain, &candidate);
            } else {
                ++unstable_gain_count;
            }
        }
        rx_auto_refine_overload(ref_gain, &ref_before, top_gain,
                                &stable_gain_count);
    } else {
        for (unsigned gain = ref_gain; gain <= table->max_index; ++gain) {
            rx_auto_candidate_t candidate = {0};
            bool stable = rx_auto_measure_against_reference(
                "RX_AUTO_GAIN", (uint8_t)gain, true, 0,
                RX_AUTO_GAIN_SETTLE_MS, ref_gain, &ref_before, &candidate);
            if (stable) {
                ++stable_gain_count;
                if (rx_auto_is_rf_limit(&candidate.obs)) ++rf_limit_votes;
                rx_auto_insert_top(top_gain, &candidate);
            } else {
                ++unstable_gain_count;
            }
        }
    }

    printf("C5VRX_RX_AUTO_GAIN_DONE stable=%u unstable=%u rf_limit_votes=%u "
           "top0=%d top1=%d top2=%d\n",
           stable_gain_count, unstable_gain_count, rf_limit_votes,
           top_gain[0].valid ? (int)top_gain[0].gain : -1,
           top_gain[1].valid ? (int)top_gain[1].gain : -1,
           top_gain[2].valid ? (int)top_gain[2].gain : -1);

    rx_auto_candidate_t best_bw = {0};
    for (unsigned i = 0; i < RX_AUTO_TOP_COUNT; ++i) {
        if (!top_gain[i].valid) continue;
        for (unsigned bw_i = 0; bw_i < 2u; ++bw_i) {
            bool bw40 = bw_i == 0u;
            rx_auto_candidate_t candidate = {0};
            if (rx_auto_measure_against_reference(
                    "RX_AUTO_BW", top_gain[i].gain, bw40, 0,
                    RX_AUTO_BW_SETTLE_MS, ref_gain, &ref_before, &candidate) &&
                rx_auto_classify(&candidate.obs) != RX_AUTO_REJECT &&
                (!best_bw.valid || rx_auto_better(&candidate.obs, &best_bw.obs))) {
                best_bw = candidate;
                best_bw.valid = true;
            }
        }
    }

    rx_auto_candidate_t best_center = best_bw;
    if (best_bw.valid) {
        static const int coarse_offsets[] = {
            -1000, -750, -500, -250, 0, 250, 500, 750, 1000
        };
        for (unsigned i = 0; i < sizeof(coarse_offsets) / sizeof(coarse_offsets[0]); ++i) {
            rx_auto_candidate_t candidate = {0};
            if (rx_auto_measure_against_reference(
                    "RX_AUTO_CENTER_COARSE", best_bw.gain, best_bw.bw40,
                    coarse_offsets[i], RX_AUTO_OFFSET_SETTLE_MS,
                    ref_gain, &ref_before, &candidate) &&
                rx_auto_classify(&candidate.obs) != RX_AUTO_REJECT &&
                (!best_center.valid ||
                 rx_auto_better(&candidate.obs, &best_center.obs))) {
                best_center = candidate;
                best_center.valid = true;
            }
        }

        int center = best_center.offset_khz;
        for (int delta = -200; delta <= 200; delta += 100) {
            int offset = center + delta;
            if (offset < -1000 || offset > 1000) continue;
            rx_auto_candidate_t candidate = {0};
            if (rx_auto_measure_against_reference(
                    "RX_AUTO_CENTER_FINE", best_bw.gain, best_bw.bw40,
                    offset, RX_AUTO_OFFSET_SETTLE_MS,
                    ref_gain, &ref_before, &candidate) &&
                rx_auto_classify(&candidate.obs) != RX_AUTO_REJECT &&
                rx_auto_better(&candidate.obs, &best_center.obs)) {
                best_center = candidate;
                best_center.valid = true;
            }
        }
    }

    unsigned proof_wins = 0;
    unsigned proof_stable = 0;
    rx_auto_observation_t proof_last = {0};
    if (best_center.valid) {
        for (unsigned round = 0; round < RX_AUTO_PROOF_ROUNDS; ++round) {
            hw_transport_counters_t base0 = lab_counter_snapshot();
            rx_auto_apply_config(ref_gain, true, 0, RX_AUTO_GAIN_SETTLE_MS);
            rx_auto_observation_t before = rx_auto_collect_observation(&base0);

            hw_transport_counters_t win_base = lab_counter_snapshot();
            rx_auto_apply_config(best_center.gain, best_center.bw40,
                                 best_center.offset_khz,
                                 RX_AUTO_BW_SETTLE_MS);
            rx_auto_observation_t winner = rx_auto_collect_observation(&win_base);

            hw_transport_counters_t base1 = lab_counter_snapshot();
            rx_auto_apply_config(ref_gain, true, 0, RX_AUTO_GAIN_SETTLE_MS);
            rx_auto_observation_t after = rx_auto_collect_observation(&base1);

            bool stable = rx_auto_reference_stable(&before, &after);
            bool baseline_is_winner =
                best_center.gain == ref_gain &&
                best_center.bw40 &&
                best_center.offset_khz == 0;
            bool winner_usable =
                rx_auto_classify(&winner) >= RX_AUTO_USABLE;
            bool wins = stable && winner_usable &&
                        (baseline_is_winner ||
                         (rx_auto_better(&winner, &before) &&
                          rx_auto_better(&winner, &after)));
            if (stable) ++proof_stable;
            if (wins) ++proof_wins;
            proof_last = winner;

            printf("C5VRX_RX_AUTO_PROOF round=%u stable=%u wins=%u "
                   "base0_p=%d base0_q=%d win_p=%d win_q=%d win_clip=%d "
                   "win_origin=%d win_class=%s base1_p=%d base1_q=%d\n",
                   round + 1u, stable ? 1u : 0u, wins ? 1u : 0u,
                   before.p_median, before.q_phase,
                   winner.p_median, winner.q_phase, winner.clip_permille,
                   winner.origin_permille,
                   rx_auto_class_name(rx_auto_classify(&winner)),
                   after.p_median, after.q_phase);
        }
    }

    bool acquired = best_center.valid &&
                    proof_stable >= 4u &&
                    proof_wins >= 4u &&
                    rx_auto_classify(&proof_last) >= RX_AUTO_USABLE;

    const char *status = "INCONCLUSIVE";
    if (acquired) {
        status = "ACQUIRED";
    } else if (overload_mode && (!best_center.valid ||
               rx_auto_classify(&best_center.obs) == RX_AUTO_REJECT)) {
        status = "OVERLOAD";
    } else if (stable_gain_count > 0u &&
               rf_limit_votes * 4u >= stable_gain_count * 3u) {
        status = "RF_LIMIT";
    } else if (unstable_gain_count > stable_gain_count) {
        status = "UNSTABLE";
    }

    if (acquired) {
        rx_auto_freeze_winner(&best_center, saved.quiet);
    } else {
        rx_auto_restore_saved(&saved);
    }
    s_pre_q4_probe_active = false;

    printf("C5VRX_RX_AUTO_RESULT status=%s gain=%d bw=%d offset_khz=%d "
           "class=%s proof_wins=%u proof_stable=%u stable_gain=%u "
           "unstable_gain=%u rf_limit_votes=%u frozen=%u\n",
           status,
           best_center.valid ? (int)best_center.gain : -1,
           best_center.valid ? (best_center.bw40 ? 40 : 20) : -1,
           best_center.valid ? best_center.offset_khz : 0,
           best_center.valid ?
               rx_auto_class_name(rx_auto_classify(&best_center.obs)) : "NONE",
           proof_wins, proof_stable, stable_gain_count,
           unstable_gain_count, rf_limit_votes, acquired ? 1u : 0u);

    if (acquired) {
        printf("C5VRX_RX_AUTO_NEXT frontend_frozen=1 action=demod_ab "
               "note=keep_RF_tuple_fixed_when_comparing_Golden_Adjacent_Alpha\n");
    } else if (status[0] == 'R' && status[1] == 'F') {
        printf("C5VRX_RX_AUTO_NEXT frontend_frozen=0 action=pre_q4 "
               "tests=fresh_calibration_then_RXDC_IQ_ADC_filter\n");
    }
}


/* Print the vendor-generated receive model without changing any PHY state. */
static void lab_print_arc_oracle(void)
{
    const arc_gain_table_t *table = rf_get_arc_gain_table();
    const rf_phy_snapshot_t *tuple = rf_get_arc_receive_tuple();
    printf("C5VRX_ARC_ORACLE generation=%" PRIu32 " max=%u source=%s survival=%u spans=",
           rf_get_arc_generation(),
           table->max_index,
           table->runtime_spans_valid ? "vendor" : "fallback",
           rf_get_arc_survival_gain());
    for (unsigned i = 0; i < ARC_RX_STAGE_COUNT; ++i)
        printf("%s%u", i ? "," : "", table->spans[i]);
    printf("\n");
    printf("C5VRX_ARC_CAPTURE gain=%u rf_stage=%u rf_code=%u bb=%u fine=%u "
           "filter=%u adc=%u iq=%u/%d/%d\n",
           tuple->gain_tuple.gain_index, tuple->gain_tuple.rf_stage,
           tuple->gain_tuple.rf_code, tuple->gain_tuple.bb_code,
           tuple->gain_tuple.fine_code, tuple->rx_filter_mode,
           tuple->adc_rate_sel, tuple->iq_correction.enable,
           tuple->iq_correction.coef0, tuple->iq_correction.coef1);
    lab_print_row("ARC_ORACLE", NULL);
}


static void apply_rx_profile(rx_profile_t profile)
{
    if (profile >= RX_PROFILE_COUNT) profile = RX_PROFILE_BALANCED;

    /* Leave any previous experimental state first. */
    if (s_profile_fft_forced) {
        s_last_phy_write_us = esp_timer_get_time();
        s_last_phy_write_kind = PHY_WRITE_FFT;
        rf_set_fft_scale_force(false, 0);
        s_profile_fft_forced = false;
    }

    s_rx_profile = profile;
    ++s_profile_generation;
    s_agc_state = AGC_STATE_SEARCH;

    switch (profile) {
    case RX_PROFILE_RANGE_EXP:
        s_agc_mode = ANALOG_AGC_ACTIVE;
        s_rf_bw_mode = RF_BW_MODE_BW40;
        apply_rf_bandwidth(true);
        s_afc_mode = AFC_MODE_OFF;
        if (rf_get_frequency_offset_khz() != 0) apply_frequency_offset_khz_tracked(0);
        apply_rx_gain_tracked(62u);
        break;

    case RX_PROFILE_BLOCKER_EXP:
        s_agc_mode = ANALOG_AGC_ACTIVE;
        s_rf_bw_mode = RF_BW_MODE_BW40;
        apply_rf_bandwidth(true);
        s_afc_mode = AFC_MODE_OFF;
        if (rf_get_frequency_offset_khz() != 0) apply_frequency_offset_khz_tracked(0);
        apply_rx_gain_tracked(36u);
        break;

    case RX_PROFILE_RECOVERY_EXP:
        s_agc_mode = ANALOG_AGC_ACTIVE;
        s_rf_bw_mode = RF_BW_MODE_BW40;
        apply_rf_bandwidth(true);
        s_afc_mode = AFC_MODE_AUTO;
        apply_rx_gain_tracked(52u);
        break;

    case RX_PROFILE_AUTO_EXP:
        s_agc_mode = ANALOG_AGC_ACTIVE;
        s_rf_bw_mode = RF_BW_MODE_AUTO;
        apply_rf_bandwidth(true);
        s_afc_mode = AFC_MODE_AUTO;
        apply_rx_gain_tracked(52u);
        /* FFT is only promoted after this exact boot has measured a material
         * raw-Q4 benefit with the bounded F probe. */
        if (s_fft_q4_effect_known && s_fft_q4_effective) {
            s_last_phy_write_us = esp_timer_get_time();
            s_last_phy_write_kind = PHY_WRITE_FFT;
            rf_set_fft_scale_force(true, s_fft_best_value);
            s_profile_fft_forced = true;
        }
        break;

    case RX_PROFILE_FUSION_EXP:
        s_agc_mode = ANALOG_AGC_ACTIVE;
        s_rf_bw_mode = RF_BW_MODE_BW40;
        apply_rf_bandwidth(true);
        s_afc_mode = AFC_MODE_OFF;
        if (rf_get_frequency_offset_khz() != 0) apply_frequency_offset_khz_tracked(0);
        apply_rx_gain_tracked(62u);
        break;

    case RX_PROFILE_RANGE_V2_EXP:
        /* Fusion learner plus acquisition-only gearbox/AFC. Both are already
         * hard-frozen in TRACK, so clean video remains a zero-PHY-write zone. */
        s_agc_mode = ANALOG_AGC_ACTIVE;
        s_rf_bw_mode = RF_BW_MODE_AUTO;
        apply_rf_bandwidth(true);
        s_afc_mode = AFC_MODE_AUTO;
        apply_rx_gain_tracked(62u);
        break;

    case RX_PROFILE_ARC:
        /* ARC uses only indices from the vendor-generated table. Start at the
         * first entry of the highest RF stage: maximum front-end sensitivity
         * without blindly maximizing downstream BB/fine gain. */
        s_agc_mode = ANALOG_AGC_ACTIVE;
        s_rf_bw_mode = RF_BW_MODE_BW40;
        apply_rf_bandwidth(true);
        s_afc_mode = AFC_MODE_OFF;
        if (rf_get_frequency_offset_khz() != 0) apply_frequency_offset_khz_tracked(0);
        apply_rx_gain_tracked(rf_get_arc_survival_gain());
        break;

    case RX_PROFILE_ARC_V3_EXP:
    case RX_PROFILE_ARC_V5_AUTOTUNE_EXP:
        /* Hardware-proven gain-first experiment. Keep the RF shape fixed so
         * gain placement is the only moving actuator: BW40, offset 0. Q4
         * starvation may climb above the old G62 survival entry; overload may
         * descend below it. Semantic sync is not a gain-up prerequisite. */
        s_agc_mode = ANALOG_AGC_ACTIVE;
        s_rf_bw_mode = RF_BW_MODE_BW40;
        apply_rf_bandwidth(true);
        s_afc_mode = AFC_MODE_OFF;
        if (rf_get_frequency_offset_khz() != 0) apply_frequency_offset_khz_tracked(0);
        apply_rx_gain_tracked(rf_get_arc_survival_gain());
        break;

    case RX_PROFILE_BALANCED:
    default:
        s_noise_floor_valid = false;
        s_phy_rssi_valid = false;
        s_agc_mode = ANALOG_AGC_ACTIVE;
        s_rf_bw_mode = RF_BW_MODE_BW40;
        apply_rf_bandwidth(true);
        s_afc_mode = AFC_MODE_OFF;
        if (rf_get_frequency_offset_khz() != 0) apply_frequency_offset_khz_tracked(0);
        apply_rx_gain_tracked(52u);
        break;
    }

    video_standard_detector_reset();
}

static void cycle_rx_profile(void)
{
    rx_profile_t next = (rx_profile_t)(((unsigned)s_rx_profile + 1u) % RX_PROFILE_COUNT);
    apply_rx_profile(next);
    settings_save();
    printf("[RX PROFILE] -> %s (BW=%s AFC=%s FFT=%s)\n",
           rx_profile_name(), rf_bw_mode_name(),
           s_afc_mode == AFC_MODE_AUTO ? "AUTO" :
           s_afc_mode == AFC_MODE_HOLD ? "HOLD" : "OFF",
           s_profile_fft_forced ? "FORCED" : "AUTO");
}

static void leave_experimental_profile(void)
{
    if (s_profile_fft_forced) {
        s_last_phy_write_us = esp_timer_get_time();
        s_last_phy_write_kind = PHY_WRITE_FFT;
        rf_set_fft_scale_force(false, 0);
        s_profile_fft_forced = false;
    }
    s_rx_profile = RX_PROFILE_RANGE_EXP;
    ++s_profile_generation;
}

/* Modern standalone menu renderer.
 *
 * SRAM-safe production raster: 384x56 logical pixels. Horizontal coordinates
 * use a sharp fractional 189/50 DAC-sample scale, and every logical Y row is
 * emitted on three scanlines. This makes the on-screen controls 50% taller without the
 * oversized 400x72x4 backing store that exceeded ESP32-C5 DRAM.
 */
enum {
    UI_ROOT = 22,
    UI_HEADER = 24,
    UI_PANEL = 26,
    UI_PANEL_2 = 29,
    UI_DIVIDER = 33,
    UI_MUTED = 39,
    UI_SELECTED = 43,
    UI_SELECTED_EDGE = 48,
    UI_STRONG = 54,
    UI_WHITE = 60,
};

static const uint8_t s_menu_icons[6][8] = {
    {0x10,0x38,0x54,0x10,0x10,0x38,0x7c,0x00}, /* band / antenna */
    {0x7e,0x42,0x5a,0x5a,0x5a,0x42,0x7e,0x00}, /* channel */
    {0x00,0x40,0x50,0x54,0x55,0x55,0x55,0x00}, /* RF bars */
    {0x10,0x10,0x54,0x38,0x54,0x10,0x10,0x00}, /* AFC crosshair */
    {0x7e,0x42,0x42,0x42,0x7e,0x18,0x3c,0x00}, /* video */
    {0x7c,0x44,0x04,0x1f,0x04,0x44,0x7c,0x00}, /* exit */
};
static const char *const s_menu_nav[6] = {
    "BAND", "CHANNEL", "RF", "AFC", "VIDEO", "EXIT"
};

static inline void menu_ui_pixel(int x, int y, uint8_t code)
{
    if ((unsigned)x >= MENU_UI_WIDTH || (unsigned)y >= MENU_UI_LINES) return;
    unsigned x0 = (unsigned)x * MENU_UI_X_SCALE_NUM / MENU_UI_X_SCALE_DEN;
    unsigned x1 = (unsigned)(x + 1) * MENU_UI_X_SCALE_NUM / MENU_UI_X_SCALE_DEN;
    memset(&s_menu_raster.ui[y][x0], code, x1 - x0);
}

static void menu_ui_rect(int x, int y, int w, int h, uint8_t code)
{
    if (w <= 0 || h <= 0) return;
    int x0 = x < 0 ? 0 : x;
    int y0 = y < 0 ? 0 : y;
    int x1 = x + w > (int)MENU_UI_WIDTH ? (int)MENU_UI_WIDTH : x + w;
    int y1 = y + h > (int)MENU_UI_LINES ? (int)MENU_UI_LINES : y + h;
    if (x1 <= x0 || y1 <= y0) return;
    for (int yy = y0; yy < y1; ++yy) {
        unsigned sx0 = (unsigned)x0 * MENU_UI_X_SCALE_NUM / MENU_UI_X_SCALE_DEN;
        unsigned sx1 = (unsigned)x1 * MENU_UI_X_SCALE_NUM / MENU_UI_X_SCALE_DEN;
        memset(&s_menu_raster.ui[yy][sx0], code, sx1 - sx0);
    }
}

static void menu_ui_hline(int x, int y, int w, uint8_t code)
{
    menu_ui_rect(x, y, w, 1, code);
}

static void menu_ui_vline(int x, int y, int h, uint8_t code)
{
    menu_ui_rect(x, y, 1, h, code);
}

static void menu_ui_glyph(char ch, int x, int y, uint8_t code, unsigned scale)
{
    unsigned index = (ch >= 32 && ch <= 126) ? (unsigned)ch - 32u : 0u;
    if (scale == 0u) scale = 1u;
    for (unsigned gy = 0; gy < 8u; ++gy) {
        uint8_t bits = s_font8x8[index][gy];
        for (unsigned gx = 0; gx < 8u; ++gx) {
            if (bits & (0x80u >> gx)) {
                menu_ui_rect(x + (int)(gx * scale), y + (int)(gy * scale),
                             (int)scale, (int)scale, code);
            }
        }
    }
}

static void menu_ui_text(const char *str, int x, int y, uint8_t code)
{
    if (!str) return;
    for (; *str && x < (int)MENU_UI_WIDTH; ++str, x += 8) {
        menu_ui_glyph(*str, x, y, code, 1u);
    }
}

static void menu_ui_text_scaled(const char *str, int x, int y, uint8_t code, unsigned scale)
{
    if (!str || scale == 0u) return;
    int advance = (int)(8u * scale);
    for (; *str && x < (int)MENU_UI_WIDTH; ++str, x += advance) {
        menu_ui_glyph(*str, x, y, code, scale);
    }
}

static void menu_ui_text_right(const char *str, int right, int y, uint8_t code)
{
    size_t n = str ? strlen(str) : 0u;
    menu_ui_text(str, right - (int)(n * 8u), y, code);
}

static void menu_ui_icon(unsigned icon, int x, int y, uint8_t code)
{
    if (icon >= 6u) return;
    for (unsigned gy = 0; gy < 8u; ++gy) {
        uint8_t bits = s_menu_icons[icon][gy];
        for (unsigned gx = 0; gx < 8u; ++gx) {
            if (bits & (0x80u >> gx)) menu_ui_pixel(x + (int)gx, y + (int)gy, code);
        }
    }
}

static void menu_ui_value_box(int x, int y, int w, const char *label, const char *value)
{
    menu_ui_rect(x, y, w, 10, UI_PANEL_2);
    menu_ui_hline(x, y, w, UI_DIVIDER);
    menu_ui_text(label, x + 3, y + 1, UI_MUTED);
    menu_ui_text_right(value, x + w - 3, y + 1, UI_WHITE);
}

static void menu_ui_meter(int x, int y, int w, int value, int maximum)
{
    if (maximum <= 0) maximum = 1;
    if (value < 0) value = 0;
    if (value > maximum) value = maximum;
    menu_ui_rect(x, y, w, 5, UI_ROOT);
    menu_ui_rect(x + 1, y + 1, w - 2, 3, UI_PANEL_2);
    int fill = (w - 2) * value / maximum;
    if (fill > 0) menu_ui_rect(x + 1, y + 1, fill, 3, UI_STRONG);
}

static void menu_ui_signal_bars(int x, int y, int quality)
{
    int bars = quality <= 0 ? 0 : (quality >= 100 ? 5 : (quality + 19) / 20);
    for (int i = 0; i < 5; ++i) {
        int h = 2 + i;
        menu_ui_rect(x + i * 3, y + 7 - h, 2, h,
                     i < bars ? UI_WHITE : UI_DIVIDER);
    }
}

static bool menu_count_segment(void *ctx, const uint8_t *data, unsigned length)
{
    unsigned *count = (unsigned *)ctx;
    if (!count || *count >= MENU_MAX_NODES || length > 4092 ||
        ((uintptr_t)data & 3) || (length & 3)) return false;
    ++*count;
    return true;
}

static bool menu_append_segment(void *ctx, const uint8_t *data, unsigned length)
{
    (void)ctx;
    if (!s_menu_nodes || s_menu_node_count >= s_menu_node_capacity ||
        length > 4092 || ((uintptr_t)data & 3) || (length & 3)) return false;
    dma_descriptor_t *node = &s_menu_nodes[s_menu_node_count++];
    memset(node, 0, sizeof(*node));
    node->dw0.size = length;
    node->dw0.length = length;
    node->dw0.owner = 1;
    node->buffer = (void *)data;
    node->next = &s_menu_nodes[s_menu_node_count];
    return true;
}

static void menu_free_nodes(void)
{
    if (!s_menu_nodes) return;
    heap_caps_free(s_menu_nodes);
    s_menu_nodes = NULL;
    s_menu_node_capacity = 0;
    s_menu_node_count = 0;
}

static void menu_render_menu(void);

static esp_err_t menu_init_buffers(void)
{
    menu_raster_init(&s_menu_raster, s_video_std);

    /* Count first and verify the generated chain against the fixed compact
     * maximum. Reserving the full two-field maximum also makes PAL/NTSC
     * switching allocation-free while menu DMA owns the raster. */
    unsigned required_nodes = 0;
    if (!menu_raster_emit(&s_menu_raster, s_video_std,
                          menu_count_segment, &required_nodes) ||
        required_nodes == 0 || required_nodes > MENU_MAX_NODES) {
        return ESP_ERR_INVALID_SIZE;
    }

    if (s_menu_node_capacity < MENU_MAX_NODES) {
        menu_free_nodes();
        size_t bytes = MENU_MAX_NODES * sizeof(*s_menu_nodes);
        size_t alloc_bytes = (bytes + 63u) & ~(size_t)63u;
        s_menu_nodes = (dma_descriptor_t *)heap_caps_aligned_alloc(
            64u, alloc_bytes,
            MALLOC_CAP_DMA_DESC_AHB | MALLOC_CAP_INTERNAL);
        if (!s_menu_nodes) return ESP_ERR_NO_MEM;
        s_menu_node_capacity = MENU_MAX_NODES;
    }

    s_menu_node_count = 0;
    if (!menu_raster_emit(&s_menu_raster, s_video_std,
                          menu_append_segment, NULL) ||
        s_menu_node_count != required_nodes) {
        return ESP_ERR_INVALID_SIZE;
    }
    s_menu_nodes[s_menu_node_count - 1].next = s_menu_nodes;
    menu_render_menu();
    sync_dma_c2m(&s_menu_raster, sizeof(s_menu_raster));
    sync_dma_c2m(s_menu_nodes, s_menu_node_count * sizeof(*s_menu_nodes));
    return ESP_OK;
}

static const char *video_standard_name(video_standard_t standard)
{
    return standard == VIDEO_STD_PAL ? "PAL 625i" : "NTSC 525i";
}

static video_standard_t resolved_menu_standard(void)
{
    if (s_video_std_mode == VIDEO_STD_MODE_PAL) return VIDEO_STD_PAL;
    if (s_video_std_mode == VIDEO_STD_MODE_NTSC) return VIDEO_STD_NTSC;
    return s_detected_video_std_valid ? s_detected_video_std : s_video_std;
}

static const char *agc_state_name(void)
{
    return s_agc_state == AGC_STATE_TRACK ? "TRACK" :
           s_agc_state == AGC_STATE_LEARN ? "LEARN" : "SEARCH";
}

static const char *agc_mode_name(void)
{
    return s_agc_mode == ANALOG_AGC_ACTIVE ? "AUTO" :
           s_agc_mode == ANALOG_AGC_SHADOW ? "SHADOW" : "MANUAL";
}

static const char *afc_mode_name(void)
{
    return s_afc_mode == AFC_MODE_AUTO ? "AUTO" :
           s_afc_mode == AFC_MODE_HOLD ? "HOLD" : "OFF";
}
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
