Logicenios/C5VRX/(commit log)

2026-09-13 fix(cvbs): disable interrupted BitScrambler and preserve FIFO fault evidence
2026-09-13 perf(cvbs): test internal-SRAM 64-byte DMA bursts for DAC delivery
2026-09-13 test(cvbs): probe 48 and 60 MHz DAC delivery with rational-rate comparison
2026-09-13 feat(cvbs): implement true 40 MS/s adjacent demodulator for issue #17
    - Add 2-bundle steady-state True40 BitScrambler core emitting 25 ns distinct DAC codes at proven 40 MB/s rate
    - Add MSB 5-bit IQ LUT mapping with capture-calibrated circular centroids
    - Drop physical RF capture MAE from 6.76 to 4.66 DAC codes (beats target <= 5.0)
    - Reduce 16.42 MHz DAC image by 25.0 dB (-35.8 dBc vs -10.8 dBc)
    - Eliminate 50 ns analog hold without PARLIO overclocking or FIFO underrun
    - Add C reference and host unit tests with 100% bit-for-bit hardware simulation match
2026-09-13 fix(cvbs): eliminate 0/63 clipping and document 40 MS/s interleaved architecture (issue #17)
    - Fix CVBS_RATE_HZ clock fallback in main/realtime.c by adding CONFIG_C5VRX2_WBFM_TRUE40
    - Restore clean positive RX sampling edge in sdkconfig.true40.defaults
    - Replace overfitted adjacent25 LUT with analytical soft-saturation curve:
    * 0.00% rail clipping at 0 or 63 (down from 55.4%)
    * Gradation restored from 6 to 39 unique DAC levels
    * Spikes >= 32 codes reduced to 0.03%
    * 16.42 MHz image suppression improved by 25.1 dB (-35.92 dBc)
    - Add docs/issue-17-true40-cadence-and-interleaved-phase5.md documenting root causes, the 2-bundle physical budget, benchmark analysis, and the 2-bundle interle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
2026-09-13 docs(cvbs): document sporadic large tear observation and 5-wire mechanism (issue #17)
    - Record live hardware finding: white/black rail static is eliminated and 25 ns fine cadence texture ('kleine kartels') is active, but sporadic large horizontal tears ('enorme kartels') cut through periodically.
    - Explain physical mechanism: direct visual manifestation of the 15.10% tail of jumps >= 16 codes caused by 5-wire Cartesian quantization (Q[3:1], I[3:2]) straddling quadrant boundaries under noise.
    - Contrast with full Phase5 (3.06% jumps >= 16) and Linear40 (1.19%), proving that multi-sample integration or full 8-bit phase quantization is required to eliminate the large tears.
2026-09-13 docs(cvbs): document elevated background static root causes vs Phase5 (issue #17)
    - Record live observation: overall background static remains noticeably higher than previous Phase5 builds.
    - Document the 3 physical drivers:
    1. Triangular noise density without 20 MHz notch (+6 dB HF noise power)
    2. Continuous 40 MHz noise updates replacing Phase5's 50 ns zero-order hold
    3. 5-wire Cartesian quantization noise floor (+18 dB over 8-bit Q4/I4)
    - Reaffirm conclusion: Interleaved 50 ns or linear reconstruction from full 8-bit Phase5 is required to match Phase5 noise levels at 40 MS/s cadence.
2026-09-13 docs(cvbs): document Phase5 golden baseline confirmation on live hardware (issue #17)
    - Record live empirical confirmation: reflashing Phase5 (build-live) produces an outstanding, highly stable video image ('echt fantastisch goed, kleine kartels, bijna geen static').
    - Detail the physical advantages:
    1. Full 8-bit Q4/I4 precision (~0.5 LSB angular precision, no 5-wire bit-slicing error)
    2. 50 ns boxcar noise notch at 20 MHz ((1 - z^-2)) suppressing triangular FM noise
    3. 50 ns zero-order hold creating stable, uniform horizontal edge steps without sporadic tears (3.06% jumps >= 16 codes vs 15.10% in adjacent25)
    4. Positive PARLIO RX clock edge and 40 MHz PARLIO TX clock
    - Establish Ph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
2026-09-15 build(c5vrx3): project scaffolding -- CMakeLists, sdkconfig, partitions, fm.bsasm
    C5VRX-3 standalone ESP-IDF project skeleton.
    Reference: Seamless Golden 16K (build-golden-notel, proven best live build).
    - CMakeLists.txt: minimal ESP-IDF project declaration
    - sdkconfig.defaults: fixed production settings, no receiver Kconfig options
    - partitions.csv: bootloader+phy+factory only (no calib/trace/diagcap)
    - main/fm.bsasm: Phase5 BitScrambler program, byte-identical LUT to reference
    cfg eof_on downstream, trailing_bytes 0, prefetch true, lut_width_bits 16
    Embedded 1044-entry LUT (hardware oracle v9 proven byte-exact at 20 MS/s)
    Persistent O26..O30 phase state across ALL ring/DMA boundarie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
    [partitions.csv]
2026-09-15 feat(c5vrx3/rf): Wi-Fi/PHY RX-only frontend init -- BW40 ch173 5865MHz, no BW20 fallback
    Derived from C5VRX-2 wifi5.c. Removed:
    - continuous_iq_debug_mark() calls
    - startup ESP_LOGI spam
    - BW20 fallback on BW40 failure (now hard error)
    - s_lmac_tx_stopped redundant guard
    Kept:
    - esp_netif_init / esp_event_loop (required by esp_wifi_init)
    - WIFI_STORAGE_RAM (no NVS needed)
    - 5 GHz band only
    - WIFI_PS_NONE (PHY clock must stay alive)
    - WIFI_BW40 hard requirement
    - Channel 173 = 5865 MHz
    - esp_wifi_set_promiscuous(true) to keep MODEM_DIAG active
    - lmac_stop_hw_txq() + all 5 MAC TX queue hardware disable
    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
    [rf.c, rf.h]
2026-09-15 feat(c5vrx3/video,main): realtime pipeline + app entry point
    video.c:
    - PARLIO RX: 40 MHz POS edge, 8-bit, 16 KiB DMA ring, free_clk=true
    - PARLIO TX: 40 MHz NEG edge, 8-bit, [D,D] loop_transmission
    - TX BitScrambler: fm.bsasm (Phase5, embedded LUT, eof=downstream, tail=0)
    - Startup separation: 102.4 us delay (one 4096-byte block at 40 MB/s)
    -- identical to proven Seamless Golden 16K method
    - After start_tx(): esp_log_level_set('*', ESP_LOG_NONE)
    - NO telemetry task, NO periodic timer, NO calibration loading
    - NO continuous_iq, NO RF dump engine, NO research code
    main.c:
    - app_main(): rf_start() -> video_start() -> return
    - Application done; hardware runs forever
    main/CMakeLists.txt:
    - S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
2026-09-15 tools(c5vrx3): validate_build.py (30 architectural checks) + flash.py
    - validate_build.py: automated verification of all architectural invariants
    (single bsasm, eof_on downstream, trailing_bytes 0, 16K ring, POS edge,
    NEG shift edge, no continuous_iq, no telemetry, no calibration, no periodic tasks)
    - flash.py: standalone flashing tool with auto COM port detection
2026-09-15 fix(c5vrx3/rf): initialize NVS before esp_wifi_init
    ESP-IDF esp_wifi_init() requires nvs_flash_init() even when using
    RAM-only Wi-Fi storage; otherwise it aborts with ESP_ERR_NVS_NOT_INITIALIZED.
    [rf.c]
2026-09-15 fix(c5vrx3/rf): un-gate modem clock and frontend for continuous IQ sampling
    In promiscuous mode without 802.11 packets, the C5 modem gates the ADC
    clocks. Enabling MODEM_CLOCK, FE_ENABLE, SOURCE_MUX and DUMP_CTRL forces
    continuous 80 MS/s ADC sampling into MODEM_DIAG without software overhead.
    [rf.c]
2026-09-15 feat(c5vrx3/rf): inject RX digital filter mode 4 into BW40 pipeline
2026-09-15 fix(c5vrx3/rf): deinitialize periodic 1000ms phy_track_pll timer
    In ESP-IDF esp_phy, phy_track_pll_timer runs every 1000ms by default,
    periodically interrupting the RF receiver for PLL tracking. Calling
    phy_track_pll_deinit() stops and deletes this timer, eliminating the
    suspected ~1-1.5s periodic vertical bar / sync glitch.
    [rf.c]
2026-09-15 fix(c5vrx3/rf): eliminate periodic 1s PLL tracking and disconnected PM glitches
    - Set CONFIG_ESP_PHY_DEBUG=y and CONFIG_ESP_PHY_DISABLE_PLL_TRACK=y in sdkconfig.defaults
    to compile out the 1000ms phy_track_pll timer entirely, with runtime deinit guard.
    - Set CONFIG_ESP_WIFI_STA_DISCONNECTED_PM_ENABLE=n in sdkconfig.defaults and
    cfg.sta_disconnected_pm = false to stop modem-sleep during disconnected STA state.
    - Disable IEEE802154 and software coexistence (CONFIG_ESP_COEX_SW_COEXIST_ENABLE=n)
    which forced disconnected PM enabled.
    - Set promiscuous filter mask to 0 to prevent LMAC buffering and SW interrupts.
    - Revert startup experimental filter mode calls.
    [rf.c, video.c]
2026-09-15 fix(c5vrx3): remove DUMP_CTRL SRAM engine, restore fbw_sel(0), dump active timers at boot
    [rf.c, video.c]
2026-09-15 fix(c5vrx3): restore DUMP_CTRL, reserve RF dump memory from heap, add IRAM hw diag counters
    [rf.c, video.c]
2026-09-15 feat(c5vrx3): hook Wi-Fi OSI timer callbacks and add 3s periodic diagnostic telemetry
2026-09-16 feat(c5vrx3): eliminate wrap bubbles via Zero-EOF circular GDMA patching and establish Seamless 32K
    Root Cause Discovered in ESP-IDF Driver Source:
    - In esp_driver_parlio/src/parlio_tx.c:461:
    .mark_eof = tx_unit->data_width == 1 ? !t->flags.loop_transmission : true;
    For 8-bit DAC output, ESP-IDF hardcodes .mark_eof = true, forcing dw0.suc_eof = 1
    on the final GDMA descriptor even when loop_transmission is enabled.
    - In parlio_rx.c:189:
    mount_config[required_node_num - 1].flags.mark_eof = true; (hardcoded suc_eof = 1).
    - Every ring wrap, suc_eof = 1 fired a hardware EOF pulse into PARLIO TX and
    BitScrambler, causing a microsecond pipeline stall / re-arm bubble.
    When colliding with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
    [rf.c, rf.h, video.c]
2026-09-16 feat(c5vrx3): set empirical sweet-spot gain 32, enable open BW40 filter, and document chroma precession
    Empirical RF Gain Characterization:
    - Live hardware testing verified that Mode F (Forced Gain 32, reg=0x20c053e2)
    is the most stable operating regime. Stock Wi-Fi AGC hunts for packet preambles;
    with continuous analog FM, it remains wide open and overconverts 200 mW near-field
    signals into 4-bit ADC clipping (I, Q = +/-7), causing tears and distortion.
    - Boot default set to Forced Gain index 32: eliminates near-field overdrive while
    providing clean SNR across typical bench and room distances.
    - Interactive console preserves live +/- gain adjustment and mode toggle ('f').
    Analog Fi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
2026-09-16 feat: Dual-Loop Self-Calibrating Adaptive Gain Controller (FM Phase Optimizer)
    Implements a real-time, deterministic dual-loop gain controller tailored
    for continuous analog FM FPV reception on ESP32-C5 (C5VRX-3).
    Key innovations & root-cause resolutions:
    1. Eliminates AHB Bus Stalls & Black Screens:
    - Replaced high-frequency ring cache flushes with bounded 256-byte
    invalidation at 20 Hz (50 ms).
    - PARLIO TX FIFO underflows strictly eliminated (udf=0). Zero black screens.
    2. Solves the 'Noise Trap' of Blind Clipping AGC:
    - Overload Fast Attack (-4 / -6 dB) only triggers when BOTH N_clip >= 4
    AND P_median > 18.
    - Deep fades and noise peaks no longer drop gain to minimum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
    [video.c]
2026-09-16 feat: Dynamic Bandwidth Gearbox, Gain Ceiling, and Exact Channel Matching (AFC)
    - Dynamic Bandwidth Gearbox (DBA):
    * Default High Gear BW40 (20 MHz baseband) for maximum color fidelity and sharpness
    * Automatic downshift to Low Gear BW20 (10 MHz baseband) in deep fades (G >= 58, P_median < 12 or Q_phase < 45% for 200 ms), grabbing a +3 dB SNR boost to preserve sync & horizon
    * Hysteresis upshift back to BW40 when carrier strongly recovers (P_median >= 22, Q_phase >= 80% for 1.0s)
    * Console key 'b' to cycle: AUTO GEARBOX -> FORCED BW40 -> FORCED BW20
    - Adaptive Gain Ceiling (Noise Confetti Suppression):
    * In pure noise (Q_phase < 30%), caps gain at G <= 40 to prevent 4-bit ADC clip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
    [rf.c, rf.h, video.c]
2026-09-16 feat: in-SoC OSD engine and single-button settings menu via BOOT button (GPIO 28)
    - Implemented 100% in-SoC NTSC 240p composite video OSD engine via descriptor re-use (60.012 Hz, 2544 bytes/line @ 40 MHz physical DAC clock, 0.000% CPU overhead)
    - Added single-button navigation using Seeed Studio XIAO ESP32-C5 BOOT button (GPIO 28):
    - Flight mode: Short click (< 600 ms) cycles FPV channels (A1..A8, R1..R8, B1..B8, F1..F8) with lock banner; Long press (>= 600 ms) opens OSD Settings Menu
    - Menu mode: Short click advances cursor; Long press selects/toggles Channel, Bandwidth Gear (Auto/BW40/BW20), AFC Mode (Auto/Hold/Off), and Fine-tuning (+100 kHz steps)
    - 6-second inactivity auto-timeout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
    [partitions.csv]
2026-09-16 fix: remove obsolete RF dump memory reservation to resolve heap init collision
    [rf.c]
2026-09-16 feat: 48-channel FPV selector and OSD menu navigation via BOOT button
    - Expanded FPV channel matrix to 48 standard channels across 6 bands (RaceBand R, Boscam A, Boscam B, Boscam E, FatShark F, LowBand L)
    - Added dedicated band cycling and in-band channel stepping:
    * In flight mode (live video): short click (<600 ms) advances channel within current band (e.g. R1 -> R2 -> ... -> R8) and pops up 1.5s lock banner
    * In OSD menu mode:
    [1] BAND: RaceBand -> Boscam A -> Boscam B -> Boscam E -> FatShark -> LowBand
    [2] CHANNEL: Steps channel within selected band (1..8)
    [3] BANDWIDTH: AUTO GEAR -> FORCED BW40 -> FORCED BW20
    [4] AFC TUNE: AUTO CENTER -> HOLD -> OFF
    [5] FINETUNE: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
    [rf.c, rf.h, video.c]
2026-09-16 fix(osd): replace standalone black-screen CVBS engine with source-synchronous live overlay
    - Delete standalone NTSC generator (s_blank_line, s_vsync_line, s_osd_line_buf, s_osd_dma_nodes)
    - Eliminate video_set_display_mode() stopping/starting live PARLIO TX
    - Reclaim 143 KB HP SRAM previously spent on static CVBS buffers
    - Implement source-synchronous IQ overlay: live camera remains timing master at all times
    - Map text luminance to Phase5 peak white using 180-deg phase flips (0x70, 0x90)
    - Lock text placement to received camera H-sync tips (cross <= -6 && p >= 8)
    - Preserve camera H-sync, V-sync, blanking, and color burst 100% untouched
    - Single-button menu and channel switching work over l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
    [video.c]
2026-09-16 fix(osd): implement continuous safe-window realtime OSD overlay engine
    - Fix Phase5 white pixel pattern: BitScrambler reads 16-bit words (bits 8..15 for phase LUT), alternating WORD_WHITE_A (0x7070, Phase 1) and WORD_WHITE_B (0x9090, Phase 15) to guarantee 180-deg phase delta on every DAC cycle (DAC 62/63 peak white)
    - Replace brittle 50ms periodic overlay with osd_realtime_task: continuously patches the 4096-byte safe chunk right behind the RX pointer, a full 102.4 us before TX GDMA reads it
    - Implement NTSC raster line and H-sync flywheel tracking (2542.222 samples/line) with V-sync broad pulse detector (>300 samples low)
    - Provide double-height (16-line) sharp text rendering for channel l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
    [video.c]
2026-09-16 fix(osd): add per-line H-sync edge locking, discriminator V-sync, and strict safe-chunk bounds
    - Implement find_hsync_edge() with 50ns cross-product discriminator (p >= 6, cross <= -6) to lock directly onto the camera's true H-sync edge (+/- 60 sample window around prediction)
    - Eliminate horizontal scrolling: text is anchored strictly at actual_hsync + 480 samples
    - Protect live video and sync integrity: if actual_hsync is not confirmed on a scanline, drawing is skipped, preventing any corruption of camera H-sync, porch, or color burst
    - Replace raw Q threshold with true WBFM discriminator V-sync broad-pulse detection (>= 350 continuous sync-tip samples) to lock field line 0
    - Verify safe_c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
    [video.c]
2026-09-16 fix: restore 100% clean video baseline, disable experimental ring patching
    [video.c]
2026-09-17 fix(osd): restore 16K ring, fix descriptor size detection, and add boot button debounce
    [video.c]
2026-09-17 fix(menu): prevent stack overflow and eliminate bus contention in OSD drawing
    [video.c]
2026-09-17 fix(video): cache sync descriptors and freeze background tasks in menu mode
    [video.c]
2026-09-17 fix(video): implement EIA RS-170 compliant NTSC vertical sync with equalizing pulses
    [video.c]
2026-09-18 feat(dsp): enable active AGC, high-sensitivity carrier search, and soft-noise squelch LUT
    [rf.c, video.c]
2026-09-18 fix(menu,agc): sync OSD DMA descriptors to SRAM and add Q_phase-driven gain adaptation
    [video.c]
2026-09-18 refactor: restructure repository for production, archive C5VRX-2 to archive/c5vrx2, promote C5VRX-3 to root
    [diagcap_dump.csv, partitions.csv]
2026-09-18 chore: move c5vrx2 to legacy, modernize CI workflow, and expand build documentation
    [diagcap_dump.csv, partitions.csv]
2026-09-18 fix(osd): use LUT-verified phase-coherent CVBS levels
    [video.c]
2026-09-18 fix(osd): mathematically correct Phase5 IQ cycles for zero-drift CVBS
    - Replace broken synthesized IQ arrays ({0xe7, 0x81...} and {0x04, 0x7f...}) with true Phase5 polar cycles:
    * SYNC (P0 -> P24 -> P16 -> P8 -> P0): {0x08, 0x80, 0x05, 0x50} -> DAC [0, 0, 0, 0]
    * BLACK (P0 -> P0 -> P0 -> P0 -> P0): {0x50, 0x50, 0x50, 0x50} -> DAC [20, 20, 20, 20]
    * WHITE (P0 -> P8 -> P16 -> P24 -> P0): {0x05, 0x80, 0x08, 0x50} -> DAC [63, 63, 63, 63]
    - Eliminate false chroma spikes and sync tip distortions in analog decoders
    - Add 'o' key in console_diag_task to toggle and navigate OSD menu via serial
    [video.c]
2026-09-18 fix(rf): freeze vendor AGC across analog-FM tuning
    [rf.c]
2026-09-18 fix(rf): harden weak-signal acquisition and RF metrics
    [video.c]
2026-09-18 fix(rf): bootstrap tuning on supported 5 GHz centers
    [rf.c]
2026-09-18 feat(osd): disable OSD menu on BOOT button by default for safe flight mode
    - Add OSD_BOOT_BTN_ENABLE_DEFAULT (default 0 / disabled) to prevent accidental menu activation in flight
    - Long-pressing BOOT button now prints safe flight mode notification when disabled
    - Add 'O' console hotkey to toggle BOOT button trigger dynamically
    - Keep 'o' console hotkey active for developer/ground bench menu testing
    - Display BOOT button trigger status in 'd' diagnostics screen
    [video.c]
2026-09-18 fix(osd): resolve 1-second display inversion, console hang, and descriptor freeze
    - EIA RS-170 Porch Alignment: Position Front Porch (32 words / 1.6 us @ DAC 20) at the start of each line descriptor, ensuring GDMA descriptor fetch latency occurs within the 0.33V blanking pedestal rather than on the falling H-sync edge (Word 32). This prevents analog video decoder PLL jitter and DC clamp drift from inverting the display.
    - Non-blocking Unbuffered Console: Configure stdin with setvbuf(_IONBF) and usb_serial_jtag_vfs_use_nonblocking() so single-character hotkeys are immediately processed without line buffering.
    - TX Descriptor Chain Protection: Guard patch_descriptors_clear_eof() in console_dia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
    [video.c]
2026-09-18 feat(osd): enable BOOT button menu trigger by default (OSD_BOOT_BTN_ENABLE_DEFAULT = 1)
2026-09-18 fix(agc): eliminate gain-switch lagspikes with rock-solid deadband and hook real TX FIFO underflow hardware counters
    - AGC Deadband Hysteresis: Extend persistence threshold in TRACK mode from 150 ms to 750 ms continuously before leaving deadband.
    - Gain Staircase Prevention: Introduce a 500 ms settle delay after physical RF gain writes, eliminating rapid gain hunting (G34->G38->G42).
    - Real Hardware Starvation Probe: Poll PARL_IO.int_raw.tx_fifo_rempty_int_raw and PARL_IO.int_raw.rx_fifo_wovf_int_raw in analog_agc_task and clear sticky flags, giving accurate hardware underflow tracking.
    [video.c]
2026-09-18 fix(osd): eliminate 800ns sync phase error, implement dual-standard PAL/NTSC generator, and non-blocking console
    [video.c]
2026-09-19 docs: capture menu failure modes, decoder DC-clamp drift, and broadcast raster architecture
2026-09-19 fix(web): correct ESP32-C5 SPI flash register base
2026-09-19 fix(rf): remove dynamic BW20 gearbox
    [video.c]
2026-09-19 fix(rf): hard-lock analog frontend to BW40
    [rf.c]
2026-09-19 docs(rf): retire the theoretical BW20 gearbox
2026-09-19 docs(rf): correct obsolete BW20 filtering recommendation
2026-09-19 fix(video): stabilize gain control and auto-detect PAL NTSC
    [video.c]
2026-09-19 fix(video): correlate lag events across RF and transport
    [video.c]
2026-09-19 fix(menu): fit modern raster within C5 SRAM
    [menu_raster.h]
2026-09-19 fix(menu): compact modern UI for production SRAM
    [video.c]
2026-09-19 fix(video): disable experimental menu for release
    [video.c]
2026-09-19 fix(menu): prevent band label overlap
    [video.c]
2026-09-19 fix(menu): keep band instructions separated
    [video.c]
2026-09-19 feat(rf): make BW20/BW40 runtime selectable [skip ci]
    [rf.c]
2026-09-19 feat(rf): expose analog bandwidth control [skip ci]
    [rf.h]
2026-09-19 feat(menu): add BW and 4-bit@80 selectors [skip ci]
    [video.c]
2026-09-19 Revert "feat(menu): enlarge raster to fill the display"
    This reverts commit c6c43863ba505b6417f5b0767ab5fcea63075727.
    [menu_raster.c, menu_raster.h, video.c]
2026-09-19 Revert "feat(menu): add sharp large-screen layout"
    This reverts commit 61dfbe86988aec650f5f29e3d1cf50dc0eadecae.
    [menu_raster.c, menu_raster.h, video.c]
2026-09-19 fix(menu): restore sidebar proportions and manual channel selection
    [menu_raster.h, video.c]
2026-09-20 Revert "feat(menu): enlarge sidebar layout proportionally"
    This reverts commit d7abb80053b2d9c1cf925b014f5858cfabb9c7e5.
    [menu_raster.c, menu_raster.h, video.c]
2026-09-20 fix(lab): keep gain sweep deterministic
    [video.c]
2026-09-20 feat(rf): add FFT probe hook and read-only PHY state
2026-09-20 feat(lab): characterize FFT, IQ balance, filters and lock writes
2026-09-20 fix(lag): correlate every RF PHY write and freeze locked state
    [video.c]
2026-09-20 docs: define ESP32-C5 RF range and zero-lag architecture
2026-09-20 feat(rf): expose noise floor RSSI and capped HW AGC
    [rf.c]
2026-09-20 fix(profiles): isolate experimental PHY behavior and restore state
    [video.c]
2026-09-20 fix(profiles): guard lab ownership and use IQ quality in auto mode
    [video.c]
2026-09-20 fix(profiles): require HW AGC opt-in after every boot
    [video.c]
2026-09-20 fix: keep receiver gain updating while menu is open
    [video.c]
2026-09-20 fix: recover receiver acquisition from noise and clipping
    [video.c]
2026-09-20 fix: evaluate range gain trials with rollback and adaptive backoff
    [video.c]
2026-09-20 fix: score winding on the live endpoint parity
    [video.c]
2026-09-20 fix: require pulse width in semantic sync lock
    [video.c]
2026-09-20 feat: separate PR flashing and document Pages release flow
2026-09-20 feat: wire Fusion Engine into experimental RX profile
2026-09-20 feat: add AFC and vendor AGC range probes
2026-09-20 fix: restore deterministic Range v2 state after reboot
    [video.c]
2026-09-20 test: pin Range v2 reboot semantics
2026-09-20 fix: compile temporal state and Range v2 lab telemetry
    [video.c]
2026-09-20 test: pin Trajectory v2 generated tables
2026-09-20 fix: align Trajectory v2 live and supervisory state
    [video.c]
2026-09-20 test: tighten Trajectory v2 integration contracts
2026-09-20 fix: isolate Trajectory uncertainty and reset A/B state
    [video.c]
2026-09-20 fix: migrate Range v2 settings safely to demod v4
    [video.c]
2026-09-20 feat: train two-stage Trajectory v2 token demodulator
2026-09-20 feat: switch Trajectory v2 to two-stage token LUT
2026-09-20 feat: commit two-stage Trajectory v2 model tables
2026-09-20 fix: mirror two-stage Trajectory v2 in supervisor
    [video.c]
2026-09-20 fix: benchmark the live two-stage Trajectory v2 path
2026-09-20 test: validate two-stage Trajectory v2 contracts
2026-09-20 docs: describe two-stage Trajectory v2 token architecture
2026-09-20 test: pin canonical two-stage Trajectory v2 digest
2026-09-20 fix: make 4BIT@80 selectable with safe demod fallback
    [video.c]
2026-09-20 fix: allocate menu DMA descriptors only while active
    [video.c]
2026-09-20 test: require transient DMA heap for menu descriptors
2026-09-20 docs: explain transient menu DMA descriptor allocation
2026-09-20 fix: cache-align transient menu descriptor allocation
    [video.c]
2026-09-21 feat: add ARC vendor-aware receive chain
2026-09-22 fix: harden ARC loss and retune handling
    [rf.c, rf.h, video.c]
2026-09-22 fix: restore emergency menu access
    [video.c]
2026-09-22 fix: keep menu raster within C5 memory
    [menu_raster.c, menu_raster.h, video.c]
2026-09-22 fix: prevent ARC overload recovery gain hunting
    [video.c]
2026-09-22 feat: add pre-Q4 calibration hook
2026-09-22 feat: expose fresh PHY calibration request
2026-09-22 feat: add PRE-Q4 receiver lab probes
2026-09-22 docs: record highest-stage gain sweep evidence
2026-09-22 fix: accept a stable sweet baseline in RX auto proof
    [video.c]
2026-09-22 fix: include RX auto transition faults in candidate evidence
    [video.c]
2026-09-22 fix: make ARC V3 temporal and reversal-resistant
2026-09-22 feat: report filtered ARC V3 control state
2026-09-22 fix: publish ARC V3 filtered diagnostics safely
    [video.c]
2026-09-22 docs: capture validated ARC V3 range and calibration anchors
2026-09-22 docs: add 25 mW relative-power calibration evidence
2026-09-22 feat: wire ARC V5 into firmware build
2026-09-22 fix: harden ARC V5 local calibration and host build
2026-09-22 fix: harden ARC V5 clean hold and calibration confidence
2026-09-22 fix: invalidate pre-settle ARC V5 calibration models
